justin040304/Stage-TEST-OK/Requirements/TCC1800-UE(A)_poortverschillen.xlsx

 |  |  |  | Specs
 |  |  |  |  |  |  |  |  |  |  |  |  |  |  |  |  |  |  |  |  |  |  | TCC1800-UE |  |  |  |  |  |  |  |  |  |  | TCC1800-UEA
 |  | connector A |  | TCC1800-UE |  |  |  |  |  |  |  | TCC1800-UEA |  |  |  |  |  |  |  |  | connector C |  | Digital inputs |  |  |  |  |  |  |  |  | Digital outputs |  | digital inputs |  |  |  |  |  |  |  |  | Digital outputs
 | pinnummer | TCC1800-UE | TCC1800-UEA | input range | ADC | resolution |  |  |  |  |  | input range | ADC | resolution |  |  |  |  |  | pinnummer | TCC1800-UE | TCC1800-UEA | Schmitt trigger: Low-to-High |  | Schmitt trigger: High-to-LOW |  | extra functionalies |  | max input freq | resolution |  | max out current | extra: connected to | Schmitt trigger: Low-to-High | Schmitt trigger: High-to-LOW | max input voltage | extra functionalies |  | max input freq | resolution |  |  | max out current | extra: connected to
 | 1 | ANA_IN_1 | Analog Input 1 | 0 V ...24 V | 12 bit | 5,9 mV |  |  |  |  |  | 0...60 V | 24 bit | 1 mV | Group 1: 7 single, 3 differential |  |  |  |  | 1 | GND | GND
 | 2 | GND | Analog Input group 1 GND |  |  |  |  |  |  |  |  |  |  |  |  |  |  |  |  | 2 | DIG_IN_1 / DIG_OUT_6.1 | Digital Input 1 / Digital Output 6.1 | 1,5 V |  | 0,75 V |  | 32 bit pulse counter | frequency counter | 3 MHz |  |  | sink: 100mA, peak: 250 mA | power shift register | 16,8V/8,4V/3,5V/1,5V/1,8V | 7V/3,5V/1,45V/0,63V/0,75V | 24 V | 32 bit pulse counter | frequency counter | 3 MHz |  |  |  | sink: 250mA, peak: 1 A | power shift register
 | 3 | ANA_IN_2 | Analog Input 2 + | 0-24 V | 12 bit | 5,9 mV |  |  |  |  |  | 0...60 V | 24 bit | 1 mV |  |  |  |  |  | 3 | DIG_IN_2 / DIG_OUT_6.2 | Digital Input 2 / Digital Output 6.2 | 1,5 V |  | 0,75 V |  | 32 bit pulse counter | pulse width | 200 kHz | 1 us |  | sink: 100mA, peak: 250 mA | power shift register | 16,8V/8,4V/3,5V/1,5V/1,8V | 7V/3,5V/1,45V/0,63V/0,75V | 24 V | 32 bit pulse counter | pulse width | 200 kHz | 1 us |  |  | sink: 250mA, peak: 1 A | power shift register
 | 4 | GND | Analog Input 2 - |  |  |  |  |  |  |  |  | 0…-60 V | 24 bit | 1 mV |  |  |  |  |  | 4 | DIG_IN_3 / DIG_OUT_6.3 | Digital Input 3 / Digital Output 6.3 | 1,5 V |  | 0,75 V |  | 32 bit pulse counter | pulse width | 200 kHz | 1 us |  | sink: 100mA, peak: 250 mA | power shift register | 16,8V/8,4V/3,5V/1,5V/1,8V | 7V/3,5V/1,45V/0,63V/0,75V | 24 V | 32 bit pulse counter | pulse width | 200 kHz | 1 us |  |  | sink: 250mA, peak: 1 A | power shift register
 | 5 | ANA_IN_3 | Analog Input 3 + | 0-24 V | 12 bit | 5,9 mV |  |  |  |  |  | 0...60 V | 24 bit | 1 mV |  |  |  |  |  | 5 | DIG_IN_4 / DIG_OUT_6.4 | Digital Input 4 / Digital Output 6.4 | 1,5 V |  | 0,75 V |  | 32 bit pulse counter | pulse width | 200 kHz | 1 us |  | sink: 100mA, peak: 250 mA | power shift register | 16,8V/8,4V/3,5V/1,5V/1,8V | 7V/3,5V/1,45V/0,63V/0,75V | 24 V | 32 bit pulse counter | pulse width | 200 kHz | 1 us |  |  | sink: 250mA, peak: 1 A | power shift register
 | 6 | GND | Analog Input 3 - |  |  |  |  |  |  |  |  | 0…-60 V | 24 bit | 1 mV |  |  |  |  |  | 6 | DIG_IN_5 / DIG_OUT_6.5 | Digital Input 5 / Digital Output 6.5 | 1,5 V |  | 0,75 V |  | 32 bit pulse counter | pulse width | 200 kHz | 1 us |  | sink: 100mA, peak: 250 mA | power shift register | 16,8V/8,4V/3,5V/1,5V/1,8V | 7V/3,5V/1,45V/0,63V/0,75V | 24 V | 32 bit pulse counter | pulse width | 200 kHz | 1 us |  |  | sink: 250mA, peak: 1 A | power shift register
 | 7 | ANA_IN_4 | Analog Input 4 + | 0-24 V | 12 bit | 5,9 mV |  |  |  |  |  | 0...60 V | 24 bit | 1 mV |  |  |  |  |  | 7 | DIG_IN_6 / DIG_OUT_6.6 | Digital Input 6 / Digital Output 6.6 | 1,5 V |  | 0,75 V |  |  |  |  |  |  | sink: 100mA, peak: 250 mA | power shift register | 16,8V/8,4V/3,5V/1,5V/1,8V | 7V/3,5V/1,45V/0,63V/0,75V | 24 V |  |  |  |  |  |  | sink: 250mA, peak: 1 A | power shift register
 | 8 | GND | Analog Input 4 - |  |  |  |  |  |  |  |  | 0…-60 V | 24 bit | 1 mV |  |  |  |  |  | 8 | DIG_IN_7 / DIG_OUT_6.7 | Digital Input 7 / Digital Output 6.7 | 1,5 V |  | 0,75 V |  |  |  |  |  |  | sink: 100mA, peak: 250 mA | power shift register | 16,8V/8,4V/3,5V/1,5V/1,8V | 7V/3,5V/1,45V/0,63V/0,75V | 24 V |  |  |  |  |  |  | sink: 250mA, peak: 1 A | power shift register
 | 9 | ANA_IN_5 | Analog Input 5 | 0-24 V | 12 bit | 5,9 mV |  |  |  |  |  | 0...60 V | 24 bit | 1 mV | Group 2: 7 single, 3 differential |  |  |  |  | 9 | DIG_IN_8 / DIG_OUT_6.8 | Digital Input 8 / Digital Output 6.8 | 1,5 V |  | 0,75 V |  |  |  |  |  |  | sink: 100mA, peak: 250 mA | power shift register | 16,8V/8,4V/3,5V/1,5V/1,8V | 7V/3,5V/1,45V/0,63V/0,75V | 24 V |  |  |  |  |  |  | sink: 250mA, peak: 1 A | power shift register
 | 10 | GND | Analog Input group 2 GND |  |  |  |  |  |  |  |  |  |  |  |  |  |  |  |  | 10 | GND | GND
 | 11 | ANA_IN_6 | Analog Input 6 + | 0-24 V | 12 bit | 5,9 mV |  |  |  |  |  | 0...60 V | 24 bit | 1 mV |  |  |  |  |  | 11 | DIG_IN_9 / SPI_DI | Digital Input 9 / SPI_DI | 1,5 V |  | 0,75 V |  |  |  |  |  |  |  |  | 16,8V/8,4V/3,5V/1,5V/1,8V | 7V/3,5V/1,45V/0,63V/0,75V | 24 V
 | 12 | GND | Analog Input 6 - |  |  |  |  |  |  |  |  | 0…-60 V | 24 bit | 1 mV |  |  |  |  |  | 12 | DIG_IN_10 | Digital Input 10 | 1,5 V |  | 0,75 V |  |  |  |  |  |  |  |  | 16,8V/8,4V/3,5V/1,5V/1,8V | 7V/3,5V/1,45V/0,63V/0,75V | 24 V
 | 13 | ANA_IN_7 | Analog Input 7 + | 0-24 V | 12 bit | 5,9 mV |  |  |  |  |  | 0...60 V | 24 bit | 1 mV |  |  |  |  |  | 13 | DIG_IN_11 | Digital Input 11 | 1,5 V |  | 0,75 V |  |  |  |  |  |  |  |  | 16,8V/8,4V/3,5V/1,5V/1,8V | 7V/3,5V/1,45V/0,63V/0,75V | 24 V
 | 14 | GND | Analog Input 7 - |  |  |  |  |  |  |  |  | 0…-60 V | 24 bit | 1 mV |  |  |  |  |  | 14 | DIG_IN_12 | Digital Input 12 | 1,5 V |  | 0,75 V |  |  |  |  |  |  |  |  | 16,8V/8,4V/3,5V/1,5V/1,8V | 7V/3,5V/1,45V/0,63V/0,75V | 24 V
 | 15 | ANA_IN_8 | Analog Input 8 + | 0-24 V | 12 bit | 5,9 mV |  |  |  |  |  | 0...60 V | 24 bit | 1 mV |  |  |  |  |  | 15 | DIG_IN_13 | Digital Input 13 | 1,5 V |  | 0,75 V |  |  |  |  |  |  |  |  | 16,8V/8,4V/3,5V/1,5V/1,8V | 7V/3,5V/1,45V/0,63V/0,75V | 24 V
 | 16 | GND | Analog Input 8 - |  |  |  |  |  |  |  |  | 0…-60 V | 24 bit | 1 mV |  |  |  |  |  | 16 | DIG_IN_14 | Digital Input 14 | 1,5 V |  | 0,75 V |  |  |  |  |  |  |  |  | 16,8V/8,4V/3,5V/1,5V/1,8V | 7V/3,5V/1,45V/0,63V/0,75V | 24 V
 | 17 | ANA_IN_9 | Analog Input 9 | 0-24 V | 12 bit | 5,9 mV |  |  |  |  |  | 0...60 V | 24 bit | 1 mV | Group 3: 7 single, 3 differential |  |  |  |  | 17 | DIG_IN_15 | Digital Input 15 | 1,5 V |  | 0,75 V |  |  |  |  |  |  |  |  | 16,8V/8,4V/3,5V/1,5V/1,8V | 7V/3,5V/1,45V/0,63V/0,75V | 24 V
 | 18 | GND | Analog Input group 3 GND |  |  |  |  |  |  |  |  |  |  | 1 mV |  |  |  |  |  | 18 | DIG_IN_16 | Digital Input 16 | 1,5 V |  | 0,75 V |  |  |  |  |  |  |  |  | 16,8V/8,4V/3,5V/1,5V/1,8V | 7V/3,5V/1,45V/0,63V/0,75V | 24 V
 | 19 | ANA_IN_10 | Analog Input 10 + | 0-24 V | 12 bit | 5,9 mV |  |  |  |  |  | 0...60 V | 24 bit | 1 mV |  |  |  |  |  | 19 | GND | GND
 | 20 | GND | Analog Input 10 - |  |  |  |  |  |  |  |  | 0…-60 V | 24 bit | 1 mV |  |  |  |  |  | 20 | DIG_IN_17 | Digital Input 17 / ETHERNET P4- | 1,5 V |  | 0,75 V |  |  |  |  |  |  |  |  | 16,8V/8,4V/3,5V/1,5V/1,8V | 7V/3,5V/1,45V/0,63V/0,75V | 24 V
 | 21 | ANA_IN_11 | Analog Input 11 + | 0-24 V | 12 bit | 5,9 mV |  |  |  |  |  | 0...60 V | 24 bit | 1 mV |  |  |  |  |  | 21 | DIG_IN_18 | Digital Input 18 / ETHERNET P4+ | 1,5 V |  | 0,75 V |  |  |  |  |  |  |  |  | 16,8V/8,4V/3,5V/1,5V/1,8V | 7V/3,5V/1,45V/0,63V/0,75V | 24 V
 | 22 | GND | Analog Input 11 - |  |  |  |  |  |  |  |  | 0…-60 V | 24 bit | 1 mV |  |  |  |  |  | 22 | DIG_IN_19 | Digital Input 19 / ETHERNET P3- | 1,5 V |  | 0,75 V |  |  |  |  |  |  |  |  | 16,8V/8,4V/3,5V/1,5V/1,8V | 7V/3,5V/1,45V/0,63V/0,75V | 24 V
 | 23 | ANA_IN_12 | Analog Input 12 + | 0-24 V | 12 bit | 5,9 mV |  |  |  |  |  | 0...60 V | 24 bit | 1 mV |  |  |  |  |  | 23 | DIG_IN_20 | Digital Input 20 / ETHERNET P3+ | 1,5 V |  | 0,75 V |  |  |  |  |  |  |  |  | 16,8V/8,4V/3,5V/1,5V/1,8V | 7V/3,5V/1,45V/0,63V/0,75V | 24 V
 | 24 | GND | Analog Input 12 - |  |  |  |  |  |  |  |  | 0…-60 V | 24 bit | 1 mV |  |  |  |  |  | 24 | ETHERNET_RX+ | Digital Input 21 / ETHERNET P2- |  |  |  |  |  |  |  |  |  |  |  | 16,8V/8,4V/3,5V/1,5V/1,8V | 7V/3,5V/1,45V/0,63V/0,75V | 24 V
 | 25 | ANA_IN_13 | Analog Input 13 | 0-24 V | 12 bit | 5,9 mV |  |  |  |  |  | 0...60 V | 24 bit | 1 mV | Group 4: 7 single, 3 differential |  |  |  |  | 25 | ETHERNET_RX- | Digital Input 22 / ETHERNET P2+ |  |  |  |  |  |  |  |  |  |  |  | 16,8V/8,4V/3,5V/1,5V/1,8V | 7V/3,5V/1,45V/0,63V/0,75V | 24 V
 | 26 | GND | Analog Input group 4 GND |  |  |  |  |  |  |  |  |  |  |  |  |  |  |  |  | 26 | ETHERNET_TX+ | Digital Input 23 / ETHERNET P1- |  |  |  |  |  |  |  |  |  |  |  | 16,8V/8,4V/3,5V/1,5V/1,8V | 7V/3,5V/1,45V/0,63V/0,75V | 24 V
 | 27 | ANA_IN_14 | Analog Input 14 + | 0-24 V | 12 bit | 5,9 mV |  |  |  |  |  | 0...60 V | 24 bit | 1 mV |  |  |  |  |  | 27 | ETHERNET_TX- | Digital Input 24 / ETHERNET P1+ |  |  |  |  |  |  |  |  |  |  |  | 16,8V/8,4V/3,5V/1,5V/1,8V | 7V/3,5V/1,45V/0,63V/0,75V | 24 V
 | 28 | GND | Analog Input 14 - |  |  |  |  |  |  |  |  | 0…-60 V | 24 bit | 1 mV |  |  |  |  |  | 28 | GND | GND
 | 29 | ANA_IN_15 | Analog Input 15 + | 0-24 V | 12 bit | 5,9 mV |  |  |  |  |  | 0...60 V | 24 bit | 1 mV |  |  |  |  |  | 29 | EXT_CLK | EXT_CLK
 | 30 | GND | Analog Input 15 - |  |  |  |  |  |  |  |  | 0…-60 V | 24 bit | 1 mV |  |  |  |  |  | 30 | EXT_IN | EXT_IN
 | 31 | ANA_IN_16 | Analog Input 16 + | 0-24 V | 12 bit | 5,9 mV |  |  |  |  |  | 0...60 V | 24 bit | 1 mV |  |  |  |  |  | 31 | EXT_LOAD | EXT_LOAD
 | 32 | GND | Analog Input 16 - |  |  |  |  |  |  |  |  | 0…-60 V | 24 bit | 1 mV
 |  |  |  | input range | ADC | resolution | max out current |  |  |  |  | input range | ADC | resolution | max out current |  |  |  |  | 32 | EXT_OUT | EXT_OUT
 | 33 | ANA_OUT_1 | Analog Output 1 | 0-24 V | 12 bit | 5,9 mV | Source: 40 mA, sink: 20 mA |  |  |  |  | 0-24 V | 12 bit | 5,9 mV | Source: 40 mA, sink: 20 mA |  |  |  |  | 33 | EXT_STROBE | EXT_STROBE
 | 34 | ANA_OUT_2 | Analog Output 2 | 0-24 V | 12 bit | 5,9 mV | Source: 40 mA, sink: 20 mA |  |  |  |  | 0-24 V | 12 bit | 5,9 mV | Source: 40 mA, sink: 20 mA |  |  |  |  | 34 | GND | GND
 |  |  |  |  |  |  |  |  |  |  |  |  |  |  |  |  |  |  |  |  |  |  | Serial channel |  |  |  |  |  |  |  |  |  |  | UART & RS485 |  |  |  | Serial channel
 |  |  |  |  |  |  |  |  |  |  |  |  |  |  |  |  |  |  |  |  |  |  | uitgangsspanning | uitgangsweerstand | baudrate | databits | parity | stop bits |  |  |  |  |  | uitgangsspanning | uitgangsweerstand | resolutie | max out current |  |  | baudrate | databits | parity | stop bits
 | 35 | GND | GND |  |  |  |  |  |  |  |  |  |  |  |  |  |  |  |  | 35 | SERIAL_RX | SERIAL TX / RS485 A | 5V | 330 Ω | 300 .. 115200 | 8 | none | 1 or 2 |  |  |  |  |  | 1,8V-5V | 100 Ω | 1.3 mV | 12mA |  |  | 300-115200 | 7 or 8 | none | 1 or 2
 | 36 | ANA_OUT_3 | Analog Output 3 | 0-24 V | 12 bit | 5,9 mV | Source: 40 mA, sink: 20 mA |  |  |  |  | 0-24 V | 12 bit | 5,9 mV | Source: 40 mA, sink: 20 mA |  |  |  |  | 36 | SERIAL_TX | SERIAL RX / RS485 B | 5V | 331 Ω | 300 .. 115200 | 9 | none | 2 or 2 |  |  |  |  |  |  | 100 Ω
 |  |  |  |  |  |  |  |  |  |  |  |  |  |  |  |  |  |  |  |  |  |  | uitgangsspanning | uitgangsstroom | uitgangsweerstand | output frequency | duty cycle |  |  |  |  |  |  | uitgangsspanning | uitgangsstroom | uitgangsweerstand | output frequency | duty cycle
 | 37 | ANA_OUT_4 | Analog Output 4 | 0-24 V | 12 bit | 5,9 mV | Source: 40 mA, sink: 20 mA |  |  |  |  | 0-24 V | 12 bit | 5,9 mV | Source: 40 mA, sink: 20 mA |  |  |  |  | 37 | PWM_1 | PWM 1 | 5V | 40mA | 100 Ω / 100mW | 2.38 Hz .. 40 MHz | 0 .. 100 % |  |  |  |  |  |  | 1,8V-5V | 12mA | 100 Ω | 2.38 Hz .. 40 MHz | 0 .. 100 %
 | 38 | GND | GND |  |  |  |  |  |  |  |  |  |  |  |  |  |  |  |  | 38 | PWM_2 | PWM 2 | 5V | 40mA | 100 Ω / 100mW | 2.38 Hz .. 40 MHz | 0 .. 100 % |  |  |  |  |  |  | 1,8V-5V | 12mA | 100 Ω | 2.38 Hz .. 40 MHz | 0 .. 100 %
 |  |  |  |  |  |  |  |  |  |  |  |  |  |  |  |  |  |  |  |  |  |  | uitgangsspanning | frequency | uitgangsweerstand | pullup resistor |  |  |  |  |  |  |  | uitgangsspanning | frequency | uitgangsweerstand | pullup resistor
 | 39 | ANA_OUT_5 | Analog Output 5 | 0-24 V | 12 bit | 5,9 mV | Source: 40 mA, sink: 20 mA |  |  |  |  | 0-24 V | 12 bit | 5,9 mV | Source: 40 mA, sink: 20 mA |  |  |  |  | 39 | I2C_SDA | I2C SDA | 5V | 100kHz or 400 kHz | 330 Ω | 100kHz: 4K7, 400kHz: 2K |  |  |  |  |  |  |  | 1,8V-5V | 100kHz or 400 kHz | 100 Ω | optional: 4K7
 | 40 | ANA_OUT_6 | Analog Output 6 | 0-24 V | 12 bit | 5,9 mV | Source: 40 mA, sink: 20 mA |  |  |  |  | 0-24 V | 12 bit | 5,9 mV | Source: 40 mA, sink: 20 mA |  |  |  |  | 40 | I2C_SCL | I2C SCL |  | 100kHz or 400 kHz | 330 Ω |  |  |  |  |  |  |  |  | 1,8V-5V | 100kHz or 400 kHz | 100 Ω
 | 41 | GND | GND |  |  |  |  |  |  |  |  |  |  |  |  |  |  |  |  | 41 | GND | GND
 | 42 | ANA_OUT_7 | Analog Output 7 | 0-24 V | 12 bit | 5,9 mV | Source: 40 mA, sink: 20 mA |  |  |  |  | 0-24 V | 12 bit | 5,9 mV | Source: 40 mA, sink: 20 mA |  |  |  |  | 42 | GND | GND
 |  |  |  |  |  |  |  |  |  |  |  |  |  |  |  |  |  |  |  |  |  |  | output voltage | max current |  |  |  |  |  |  |  |  |  | output voltage | max current
 | 43 | ANA_OUT_8 | Analog Output 8 | 0-24 V | 12 bit | 5,9 mV | Source: 40 mA, sink: 20 mA |  |  |  |  | 0-24 V | 12 bit | 5,9 mV | Source: 40 mA, sink: 20 mA |  |  |  |  | 43 | +26V | +27V / 1A | 27V…30V | 0,75A |  |  |  |  |  |  |  |  |  | 27V | 1A
 | 44 | GND | GND |  |  |  |  |  |  |  |  |  |  |  |  |  |  |  |  | 44 | +26V | +27V / 1A
 |  |  |  |  |  |  |  |  |  |  |  |  |  |  |  |  |  |  |  |  |  |  |  |  |  |  |  |  |  | current measurement
 |  |  |  |  |  |  |  |  |  |  |  |  |  |  |  |  |  |  |  |  |  |  | output voltage | resolution | bit | accuracy max | max power | max current |  | resolution | full range non-lin | stable current | power supply off | output voltage | resolution | bit | accuracy max | max power | max current |  | resolution | full range non-lin | stable current | power supply off
 | 45 | ANA_OUT_9 | Analog Output 9 | 0-24 V | 12 bit | 5,9 mV | Source: 40 mA, sink: 20 mA |  |  |  |  | 0-24 V | 12 bit | 5,9 mV | Source: 40 mA, sink: 20 mA |  |  |  |  | 45 | V_SUPPLY_1 | Supply 1 | 1,24V…24V | 6mV | 12 | 4% | 45W | 3A |  | 0,375 mA | 0,9 % typ | na 480ms | no communication PC | 1,24V…24V | 6mV | 12 | 4% | 45W | 3A |  | 0,375 mA | 0,9 % typ | na 480ms | no communication PC
 | 46 | ANA_OUT_10 | Analog Output 10 | 0-24 V | 12 bit | 5,9 mV | Source: 40 mA, sink: 20 mA |  |  |  |  | 0-24 V | 12 bit | 5,9 mV | Source: 40 mA, sink: 20 mA |  |  |  |  | 46 | GND | GND
 | 47 | GND | GND |  |  |  |  |  |  |  |  |  |  |  |  |  |  |  |  | 47 | V_SUPPLY_1 | Supply 1 | 1,24V…24V | 6mV | 12 | 4% | 45W | 3A |  | 0,375 mA | 0,9 % typ | na 480ms | no communication PC | 1,24V…24V | 6mV | 12 | 4% | 45W | 3A |  | 0,375 mA | 0,9 % typ | na 480ms | no communication PC
 | 48 | ANA_OUT_11 | Analog Output 11 | 0-24 V | 12 bit | 5,9 mV | Source: 40 mA, sink: 20 mA |  |  |  |  | 0-24 V | 12 bit | 5,9 mV | Source: 40 mA, sink: 20 mA |  |  |  |  | 48 | GND | GND
 | 49 | ANA_OUT_12 | Analog Output 12 | 0-24 V | 12 bit | 5,9 mV | Source: 40 mA, sink: 20 mA |  |  |  |  | 0-24 V | 12 bit | 5,9 mV | Source: 40 mA, sink: 20 mA |  |  |  |  | 49 | V_SUPPLY_1 | Supply 1 | 1,24V…24V | 6mV | 12 | 4% | 45W | 3A |  | 0,375 mA | 0,9 % typ | na 480ms | no communication PC | 1,24V…24V | 6mV | 12 | 4% | 45W | 3A |  | 0,375 mA | 0,9 % typ | na 480ms | no communication PC
 | 50 | GND | GND |  |  |  |  |  |  |  |  |  |  |  |  |  |  |  |  | 50 | GND | GND
 | 51 | ANA_OUT_13 | Analog Output 13 | 0-24 V | 12 bit | 5,9 mV | Source: 40 mA, sink: 20 mA |  |  |  |  | 0-24 V | 12 bit | 5,9 mV | Source: 40 mA, sink: 20 mA |  |  |  |  | 51 | V_SUPPLY_1 | Supply 1 | 1,24V…24V | 6mV | 12 | 4% | 45W | 3A |  | 0,375 mA | 0,9 % typ | na 480ms | no communication PC | 1,24V…24V | 6mV | 12 | 4% | 45W | 3A |  | 0,375 mA | 0,9 % typ | na 480ms | no communication PC
 | 52 | ANA_OUT_14 | Analog Output 14 | 0-24 V | 12 bit | 5,9 mV | Source: 40 mA, sink: 20 mA |  |  |  |  | 0-24 V | 12 bit | 5,9 mV | Source: 40 mA, sink: 20 mA |  |  |  |  | 52 | GND | GND
 | 53 | GND | GND |  |  |  |  |  |  |  |  |  |  |  |  |  |  |  |  | 53 | V_SUPPLY_1 | Supply 1 | 1,24V…24V | 6mV | 12 | 4% | 45W | 3A |  | 0,375 mA | 0,9 % typ | na 480ms | no communication PC | 1,24V…24V | 6mV | 12 | 4% | 45W | 3A |  | 0,375 mA | 0,9 % typ | na 480ms | no communication PC
 | 54 | ANA_OUT_15 | Analog Output 15 | 0-24 V | 12 bit | 5,9 mV | Source: 40 mA, sink: 20 mA |  |  |  |  | 0-24 V | 12 bit | 5,9 mV | Source: 40 mA, sink: 20 mA |  |  |  |  | 54 | GND | GND
 | 55 | ANA_OUT_16 | Analog Output 16 | 0-24 V | 12 bit | 5,9 mV | Source: 40 mA, sink: 20 mA |  |  |  |  | 0-24 V | 12 bit | 5,9 mV | Source: 40 mA, sink: 20 mA |  |  |  |  | 55 | V_SUPPLY_2 | Supply 2 | 1,24V…24V | 6mV | 12 | 4% | 45W | 3A |  | 0,375 mA | 0,9 % typ | na 480ms | no communication PC | 1,24V…24V | 6mV | 12 | 4% | 45W | 3A |  | 0,375 mA | 0,9 % typ | na 480ms | no communication PC
 | 56 | GND | GND |  |  |  |  |  |  |  |  |  |  |  |  |  |  |  |  | 56 | GND | GND
 | 57 | BOARD_DETECT | BOARD DETECT |  |  |  |  |  |  |  |  |  |  |  |  |  |  |  |  | 57 | V_SUPPLY_2 | Supply 2 | 1,24V…24V | 6mV | 12 | 4% | 45W | 3A |  | 0,375 mA | 0,9 % typ | na 480ms | no communication PC | 1,24V…24V | 6mV | 12 | 4% | 45W | 3A |  | 0,375 mA | 0,9 % typ | na 480ms | no communication PC
 | 58 | Reserved | Reserved |  |  |  |  |  |  |  |  |  |  |  |  |  |  |  |  | 58 | GND | GND
 | 59 | Reserved | Reserved |  |  |  |  |  |  |  |  |  |  |  |  |  |  |  |  | 59 | V_SUPPLY_2 | Supply 2 | 1,24V…24V | 6mV | 12 | 4% | 45W | 3A |  | 0,375 mA | 0,9 % typ | na 480ms | no communication PC | 1,24V…24V | 6mV | 12 | 4% | 45W | 3A |  | 0,375 mA | 0,9 % typ | na 480ms | no communication PC
 | 60 | GND | GND |  |  |  |  |  |  |  |  |  |  |  |  |  |  |  |  | 60 | GND | GND
 |  |  |  | Speed |  | USB hub connection | max out |  |  |  |  | Speed |  | USB hub connection | max out
 | 61 | USB_VBUS | USB VBUS2 | High speed USB 2.0 |  | ethernet | 5 V |  |  |  |  | High speed USB 2.0 |  | ethernet | 5 V |  |  |  |  | 61 | V_SUPPLY_2 | Supply 2 | 1,24V…24V | 6mV | 12 | 4% | 45W | 3A |  | 0,375 mA | 0,9 % typ | na 480ms | no communication PC | 1,24V…24V | 6mV | 12 | 4% | 45W | 3A |  | 0,375 mA | 0,9 % typ | na 480ms | no communication PC
 | 62 | USB_D+ | USB D+ |  |  |  | 500 mA |  |  |  |  |  |  |  | 500 mA |  |  |  |  | 62 | GND | GND
 | 63 | USB_D- | USB D- |  |  |  | 500 mA |  |  |  |  |  |  |  | 500 mA |  |  |  |  | 63 | V_SUPPLY_2 | Supply 2 | 1,24V…24V | 6mV | 12 | 4% | 45W | 3A |  | 0,375 mA | 0,9 % typ | na 480ms | no communication PC | 1,24V…24V | 6mV | 12 | 4% | 45W | 3A |  | 0,375 mA | 0,9 % typ | na 480ms | no communication PC
 | 64 | USB_GND | USB GND |  |  |  |  |  |  |  |  |  |  |  |  |  |  |  |  | 64 | GND | GND
 |  |  |  |  |  |  |  |  |  |  |  |  |  |  |  |  |  |  |  |  | connector P
 |  |  |  |  |  |  |  |  |  |  |  |  |  |  |  |  |  |  |  | pinnummer | TCC1800-UE | TCC1800-UEA
 | goed |  |  | Specs |  |  |  |  |  |  |  |  |  |  |  |  |  |  |  | 1 | PANEL_CLK | PANEL_CLK
 |  | connector B |  | TCC1800-UE |  |  |  |  |  |  |  | TCC1800-UEA |  |  |  |  |  |  |  | 2 | PANEL +5V | PANEL +5V
 |  |  |  |  |  |  |  |  | SPI |  |  |  |  |  |  |  | SPI |  |  | 3 | PANEL_SDI | PANEL_SDI
 | pinnummer | TCC1800-UE | TCC1800-UEA | output high | output low | output resistor | max out current | max out power | kloksnelheid |  |  | output high | output low | output resistor | max out current | max out power | kloksnelheid |  |  | 4 | PANEL_LOAD | PANEL_LOAD
 | 1 | GND | GND |  |  |  |  |  |  |  |  |  |  |  |  |  |  |  |  | 5 | PANEL_STROBE | PANEL_STROBE
 | 2 | DIG_OUT_1.1 / SPI_CLK | Digital Output 1.1 / SPI_CLK | 2,5V… 24V | 0V | 100 Ω / 100mW | Source: 30 mA, sink: 30 mA | 500mW | 78 kHz, 156.25 kHz , 312.50 kHz |  |  | 2,5V… 24V | 0,125V | 100 Ω / 100mW | Source: 30 mA, sink: 30 mA |  | 78 kHz, 156.25 kHz , 312.50 kHz |  |  | 6 | PANEL_SDO | PANEL_SDO
 | 3 | DIG_OUT_1.2 / SPI_DO | Digital Output 1.2 / SPI_DO | 2,5V… 24V | 0V | 100 Ω / 100mW | Source: 30 mA, sink: 30 mA | 500mW |  |  |  | 2,5V… 24V | 0,125V | 100 Ω / 100mW | Source: 30 mA, sink: 30 mA | 500mW |  |  |  | 7 | +DC IN | +DC IN
 | 4 | DIG_OUT_1.3 | Digital Output 1.3 | 2,5V… 24V | 0V | 100 Ω / 100mW | Source: 30 mA, sink: 30 mA | 500mW |  |  |  | 2,5V… 24V | 0,125V | 100 Ω / 100mW | Source: 30 mA, sink: 30 mA | 500mW |  |  |  | 8 | GND | GND
 | 5 | DIG_OUT_1.4 | Digital Output 1.4 | 2,5V… 24V | 0V | 100 Ω / 100mW | Source: 30 mA, sink: 30 mA | 500mW |  |  |  | 2,5V… 24V | 0,125V | 100 Ω / 100mW | Source: 30 mA, sink: 30 mA | 500mW |  |  |  | 9 | +DC IN | +DC IN
 | 6 | DIG_OUT_1.5 | Digital Output 1.5 | 2,5V… 24V | 0V | 100 Ω / 100mW | Source: 30 mA, sink: 30 mA | 500mW |  |  |  | 2,5V… 24V | 0,125V | 100 Ω / 100mW | Source: 30 mA, sink: 30 mA | 500mW |  |  |  | 10 | GND | GND
 | 7 | DIG_OUT_1.6 | Digital Output 1.6 | 2,5V… 24V | 0V | 100 Ω / 100mW | Source: 30 mA, sink: 30 mA | 500mW |  |  |  | 2,5V… 24V | 0,125V | 100 Ω / 100mW | Source: 30 mA, sink: 30 mA | 500mW |  |  |  | 11 | +DC IN | +DC IN
 | 8 | DIG_OUT_1.7 | Digital Output 1.7 | 2,5V… 24V | 0V | 100 Ω / 100mW | Source: 30 mA, sink: 30 mA | 500mW |  |  |  | 2,5V… 24V | 0,125V | 100 Ω / 100mW | Source: 30 mA, sink: 30 mA | 500mW |  |  |  | 12 | GND | GND
 | 9 | DIG_OUT_1.8 | Digital Output 1.8 | 2,5V… 24V | 0V | 100 Ω / 100mW | Source: 30 mA, sink: 30 mA | 500mW |  |  |  | 2,5V… 24V | 0,125V | 100 Ω / 100mW | Source: 30 mA, sink: 30 mA | 500mW |  |  |  | 13 | +DC IN | +DC IN
 | 10 | GND | GND |  |  |  |  |  |  |  |  |  |  |  |  | 500mW |  |  |  | 14 | GND | GND
 | 11 | DIG_OUT_2.1 | Digital Output 2.1 | 2,5V… 24V | 0V | 100 Ω / 100mW | Source: 40 mA, sink: 20 mA | 500mW |  |  |  | 2,5V… 24V | 0V | 100 Ω / 100mW | Source: 40 mA, sink: 20 mA |  |  |  |  | 15 | +DC IN | +DC IN
 | 12 | DIG_OUT_2.2 | Digital Output 2.2 | 2,5V… 24V | 0V | 100 Ω / 100mW | Source: 40 mA, sink: 20 mA | 500mW |  |  |  | 2,5V… 24V | 0V | 100 Ω / 100mW | Source: 40 mA, sink: 20 mA | 500mW |  |  |  | 16 | GND | GND
 | 13 | DIG_OUT_2.3 | Digital Output 2.3 | 2,5V… 24V | 0V | 100 Ω / 100mW | Source: 40 mA, sink: 20 mA | 500mW |  |  |  | 2,5V… 24V | 0V | 100 Ω / 100mW | Source: 40 mA, sink: 20 mA | 500mW |  |  |  | 17 | ETH1 TX- | ETH1 TX-
 | 14 | DIG_OUT_2.4 | Digital Output 2.4 | 2,5V… 24V | 0V | 100 Ω / 100mW | Source: 40 mA, sink: 20 mA | 500mW |  |  |  | 2,5V… 24V | 0V | 100 Ω / 100mW | Source: 40 mA, sink: 20 mA | 500mW |  |  |  | 18 | ETH1 RX- | ETH1 RX-
 | 15 | DIG_OUT_2.5 | Digital Output 2.5 | 2,5V… 24V | 0V | 100 Ω / 100mW | Source: 40 mA, sink: 20 mA | 500mW |  |  |  | 2,5V… 24V | 0V | 100 Ω / 100mW | Source: 40 mA, sink: 20 mA | 500mW |  |  |  | 19 | ETH1 TX+ | ETH1 TX+
 | 16 | DIG_OUT_2.6 | Digital Output 2.6 | 2,5V… 24V | 0V | 100 Ω / 100mW | Source: 40 mA, sink: 20 mA | 500mW |  |  |  | 2,5V… 24V | 0V | 100 Ω / 100mW | Source: 40 mA, sink: 20 mA | 500mW |  |  |  | 20 | ETH1 RX+ | ETH1 RX+
 | 17 | DIG_OUT_2.7 | Digital Output 2.7 | 2,5V… 24V | 0V | 100 Ω / 100mW | Source: 40 mA, sink: 20 mA | 500mW |  |  |  | 2,5V… 24V | 0V | 100 Ω / 100mW | Source: 40 mA, sink: 20 mA | 500mW |  |  |  | 21 | ETH2 TX- | ETH2 TX-
 | 18 | DIG_OUT_2.8 | Digital Output 2.8 | 2,5V… 24V | 0V | 100 Ω / 100mW | Source: 40 mA, sink: 20 mA | 500mW |  |  |  | 2,5V… 24V | 0V | 100 Ω / 100mW | Source: 40 mA, sink: 20 mA | 500mW |  |  |  | 22 | ETH2 RX- | ETH2 RX-
 | 19 | GND | GND |  |  |  |  |  |  |  |  |  |  |  |  | 500mW |  |  |  | 23 | ETH2 TX+ | ETH2 TX+
 | 20 | DIG_OUT_3.1 | Digital Output 3.1 | 2,5V… 24V | 0V | 100 Ω / 100mW | Source: 40 mA, sink: 20 mA | 500mW |  |  |  | 2,5V… 24V | 0V | 100 Ω / 100mW | Source: 40 mA, sink: 20 mA |  |  |  |  | 24 | ETH2 RX+ | ETH2 RX+
 | 21 | DIG_OUT_3.2 | Digital Output 3.2 | 2,5V… 24V | 0V | 100 Ω / 100mW | Source: 40 mA, sink: 20 mA | 500mW |  |  |  | 2,5V… 24V | 0V | 100 Ω / 100mW | Source: 40 mA, sink: 20 mA | 500mW |  |  |  | 25 | USB D- | USB D-
 | 22 | DIG_OUT_3.3 | Digital Output 3.3 | 2,5V… 24V | 0V | 100 Ω / 100mW | Source: 40 mA, sink: 20 mA | 500mW |  |  |  | 2,5V… 24V | 0V | 100 Ω / 100mW | Source: 40 mA, sink: 20 mA | 500mW |  |  |  | 26 | VBUS | VBUS
 | 23 | DIG_OUT_3.4 | Digital Output 3.4 | 2,5V… 24V | 0V | 100 Ω / 100mW | Source: 40 mA, sink: 20 mA | 500mW |  |  |  | 2,5V… 24V | 0V | 100 Ω / 100mW | Source: 40 mA, sink: 20 mA | 500mW |  |  |  | 27 | USB D+ | USB D+
 | 24 | DIG_OUT_3.5 | Digital Output 3.5 | 2,5V… 24V | 0V | 100 Ω / 100mW | Source: 40 mA, sink: 20 mA | 500mW |  |  |  | 2,5V… 24V | 0V | 100 Ω / 100mW | Source: 40 mA, sink: 20 mA | 500mW |  |  |  | 28 | USB GND | USB GND
 | 25 | DIG_OUT_3.6 | Digital Output 3.6 | 2,5V… 24V | 0V | 100 Ω / 100mW | Source: 40 mA, sink: 20 mA | 500mW |  |  |  | 2,5V… 24V | 0V | 100 Ω / 100mW | Source: 40 mA, sink: 20 mA | 500mW |  |  |  | 29 | !EXP_SELECT1 | !EXP_SELECT1
 | 26 | DIG_OUT_3.7 | Digital Output 3.7 | 2,5V… 24V | 0V | 100 Ω / 100mW | Source: 40 mA, sink: 20 mA | 500mW |  |  |  | 2,5V… 24V | 0V | 100 Ω / 100mW | Source: 40 mA, sink: 20 mA | 500mW |  |  |  | 30 | EXP_RESERVED | EXP_RESERVED
 | 27 | DIG_OUT_3.8 | Digital Output 3.8 | 2,5V… 24V | 0V | 100 Ω / 100mW | Source: 40 mA, sink: 20 mA | 500mW |  |  |  | 2,5V… 24V | 0V | 100 Ω / 100mW | Source: 40 mA, sink: 20 mA | 500mW |  |  |  | 31 | RESERVED_1 | RESERVED_1
 | 28 | GND | GND |  |  |  |  |  |  |  |  |  |  |  |  | 500mW |  |  |  | 32 | RESERVED_2 | RESERVED_2
 | 29 | DIG_OUT_4.1 | Digital Output 4.1 | 5,5V… 24V |  |  | 500 mA |  |  |  |  | 5,5V… 24V |  |  | 500 mA |  |  |  |  | Note: | diff connectors
 | 30 | DIG_OUT_4.2 | Digital Output 4.2 | 5,5V… 24V |  |  | 500 mA |  |  |  |  | 5,5V… 24V |  |  | 500 mA
 | 31 | DIG_OUT_4.3 | Digital Output 4.3 | 5,5V… 24V |  |  | 500 mA |  |  |  |  | 5,5V… 24V |  |  | 500 mA
 | 32 | DIG_OUT_4.4 | Digital Output 4.4 | 5,5V… 24V |  |  | 500 mA |  |  |  |  | 5,5V… 24V |  |  | 500 mA
 | 33 | GND | GND
 |  |  |  |  |  |  | max out current | extra: connected to |  |  |  |  |  |  | max out current | extra: connected to
 | 34 | DIG_OUT_5.1 | Digital Output 5.1 |  |  |  | sink: 100mA, peak: 250 mA | power shift register |  |  |  |  |  |  | sink: 250mA, peak: 1 A | power shift register
 | 35 | DIG_OUT_5.2 | Digital Output 5.2 |  |  |  | sink: 100mA, peak: 250 mA | power shift register |  |  |  |  |  |  | sink: 250mA, peak: 1 A | power shift register
 | 36 | DIG_OUT_5.3 | Digital Output 5.3 |  |  |  | sink: 100mA, peak: 250 mA | power shift register |  |  |  |  |  |  | sink: 250mA, peak: 1 A | power shift register
 | 37 | DIG_OUT_5.4 | Digital Output 5.4 |  |  |  | sink: 100mA, peak: 250 mA | power shift register |  |  |  |  |  |  | sink: 250mA, peak: 1 A | power shift register
 | 38 | DIG_OUT_5.5 | Digital Output 5.5 |  |  |  | sink: 100mA, peak: 250 mA | power shift register |  |  |  |  |  |  | sink: 250mA, peak: 1 A | power shift register
 | 39 | DIG_OUT_5.6 | Digital Output 5.6 |  |  |  | sink: 100mA, peak: 250 mA | power shift register |  |  |  |  |  |  | sink: 250mA, peak: 1 A | power shift register
 | 40 | DIG_OUT_5.7 | Digital Output 5.7 |  |  |  | sink: 100mA, peak: 250 mA | power shift register |  |  |  |  |  |  | sink: 250mA, peak: 1 A | power shift register
 | 41 | DIG_OUT_5.8 | Digital Output 5.8 |  |  |  | sink: 100mA, peak: 250 mA | power shift register |  |  |  |  |  |  | sink: 250mA, peak: 1 A | power shift register
 | 42 | GND | GND
 | 43 | DIG_OUT_5.9 | Digital Output 5.9 |  |  |  | sink: 100mA, peak: 250 mA | power shift register |  |  |  |  |  |  | sink: 250mA, peak: 1 A | power shift register
 | 44 | DIG_OUT_5.10 | Digital Output 5.10 |  |  |  | sink: 100mA, peak: 250 mA | power shift register |  |  |  |  |  |  | sink: 250mA, peak: 1 A | power shift register
 | 45 | DIG_OUT_5.11 | Digital Output 5.11 |  |  |  | sink: 100mA, peak: 250 mA | power shift register |  |  |  |  |  |  | sink: 250mA, peak: 1 A | power shift register
 | 46 | DIG_OUT_5.12 | Digital Output 5.12 |  |  |  | sink: 100mA, peak: 250 mA | power shift register |  |  |  |  |  |  | sink: 250mA, peak: 1 A | power shift register
 | 47 | DIG_OUT_5.13 | Digital Output 5.13 |  |  |  | sink: 100mA, peak: 250 mA | power shift register |  |  |  |  |  |  | sink: 250mA, peak: 1 A | power shift register
 | 48 | DIG_OUT_5.14 | Digital Output 5.14 |  |  |  | sink: 100mA, peak: 250 mA | power shift register |  |  |  |  |  |  | sink: 250mA, peak: 1 A | power shift register
 | 49 | DIG_OUT_5.15 | Digital Output 5.15 |  |  |  | sink: 100mA, peak: 250 mA | power shift register |  |  |  |  |  |  | sink: 250mA, peak: 1 A | power shift register
 | 50 | DIG_OUT_5.16 | Digital Output 5.16 |  |  |  | sink: 100mA, peak: 250 mA | power shift register |  |  |  |  |  |  | sink: 250mA, peak: 1 A | power shift register
 | 51 | GND | GND
 | 52 | PGM_MCLR | PGM_MCLR
 | 53 | PGM_DATA_IN | PGM_DATA_IN
 | 54 | PGM_CLK_1 (SCK) | PGM_CLK
 | 55 | GND | GND
 | 56 | Reserved | Reserved
 | 57 | PGM_DATA_OUT | PGM_DATA_OUT
 | 58 | PGM_RESET | PGM_RESET
 | 59 | +5V / 250mA supply | +5V / 500mA supply
 | 60 | GND | GND
 | 61 | PGM_VCC | PGM_VCC
 |  |  |  | baud rates |  |  | terminated resistor | common mode | separate | High-level out current | Low-level out current | baud rates |  |  | terminated resistor | common mode | separate | High-level out current | Low-level out current
 | 62 | CANL / CAN_VBAT | CANL | 20k, 25k, 50k, 80k, 100k, 125k , 200k, 250k, 500k, 625k, 1M |  |  | 120 Ω | -2V to 7V | -2,5V to 7,5V | driver:- 40 mA, rec: -8mA | driver: 48 mA, rec: 8mA | 20k, 25k, 50k, 80k, 100k, 125k , 200k, 250k, 500k, 625k, 1M |  |  | 120 Ω | -2V to 7V | -2,5V to 7,5V | driver:- 40 mA, rec: -8mA | driver: 48 mA, rec: 8mA
 | 63 | CANH | CANH
 | 64 | GND | GND
zelfde | niet zeker | verschillend
 |  |  | connector D |  |  | connector E |  |  |  |  |  | connector P
 |  | pinnummer | TCC1800-UEA |  | pinnummer | TCC1800-UEA |  | pinnummer |  |  |  | TCC1800-UE | TCC1800-UEA
 |  | 1 | Reserved |  | 1 | Lock |  | 1 |  |  |  | PANEL_CLK | PANEL_CLK
 |  | 2 | Reserved |  | 2 | V out 2 |  | 2 |  |  |  | PANEL +5V | PANEL +5V
 |  | 3 | 24V AC 2b |  | 3 | V out 2 |  | 3 |  |  |  | PANEL_SDI | PANEL_SDI
 |  | 4 | 24V AC 2b |  | 4 | V out 1 |  | 4 |  |  |  | PANEL_LOAD | PANEL_LOAD
 |  | 5 | 24V AC 2a |  | 5 | V out 1 |  | 5 |  |  |  | PANEL_STROBE | PANEL_STROBE
 |  | 6 | 24V AC 2a |  | 6 | Cover Switch |  | 6 |  |  |  | PANEL_SDO | PANEL_SDO
 |  | 7 | 24V AC 1b |  | 7 | GND |  | 7 |  |  |  | +DC IN | +DC IN
 |  | 8 | 24V AC 1b |  | 8 | V sense 2 - |  | 8 |  |  |  | GND | GND
 |  | 9 | 24V AC 1a |  | 9 | V out 2 |  | 9 |  |  |  | +DC IN | +DC IN
 |  | 10 | 24V AC 1a |  | 10 | V out 2 |  | 10 |  |  |  | GND | GND
 |  | 11 | Cover Switch |  | 11 | V out 1 |  | 11 |  |  |  | +DC IN | +DC IN
 |  | 12 | Relay |  | 12 | V out 1 |  | 12 |  |  |  | GND | GND
 |  | 13 | GND |  | 13 | Relay |  | 13 |  |  |  | +DC IN | +DC IN
 |  | 14 | +27V |  | 14 | +27V |  | 14 |  |  |  | GND | GND
 |  |  |  |  | 15 | V sense 2 + |  | 15 |  |  |  | +DC IN | +DC IN
 |  |  |  |  | 16 | V out 2 |  | 16 |  |  |  | GND | GND
 |  |  |  |  | 17 | V out 2 |  | 17 |  |  |  | ETH1 TX- | ETH1 TX-
 |  |  |  |  | 18 | V out 1 |  | 18 |  |  |  | ETH1 RX- | ETH1 RX-
 |  |  |  |  | 19 | V out 1 |  | 19 |  |  |  | ETH1 TX+ | ETH1 TX+
 |  |  |  |  | 20 | V sense 1 - |  | 20 |  |  |  | ETH1 RX+ | ETH1 RX+
 |  |  |  |  | 21 | V sense 1 + |  | 21 |  |  |  | ETH2 TX- | ETH2 TX-
 |  |  |  |  |  |  |  | 22 |  |  |  | ETH2 RX- | ETH2 RX-
 |  |  |  |  |  |  |  | 23 |  |  |  | ETH2 TX+ | ETH2 TX+
 |  |  |  |  |  |  |  | 24 |  |  |  | ETH2 RX+ | ETH2 RX+
 |  |  |  |  |  |  |  | 25 |  |  |  | USB D- | USB D-
 |  |  |  |  |  |  |  | 26 |  |  |  | VBUS | VBUS
 |  |  |  |  |  |  |  | 27 |  |  |  | USB D+ | USB D+
 |  |  |  |  |  |  |  | 28 |  |  |  | USB GND | USB GND
 |  |  |  |  |  |  |  | 29 |  |  |  | !EXP_SELECT1 | !EXP_SELECT1
 |  |  |  |  |  |  |  | 30 |  |  |  | EXP_RESERVED | EXP_RESERVED
 |  |  |  |  |  |  |  | 31 |  |  |  | RESERVED_1 | RESERVED_1
 |  |  |  |  |  |  |  | 32 |  |  |  | RESERVED_2 | RESERVED_2
 |  |  |  |  |  |  |  | Note: |  |  |  | diff connectors
