justin040304/Stage-TEST-OK/afbeeldingen/Documentatiefout TCC1800-UEA ref man.PNG

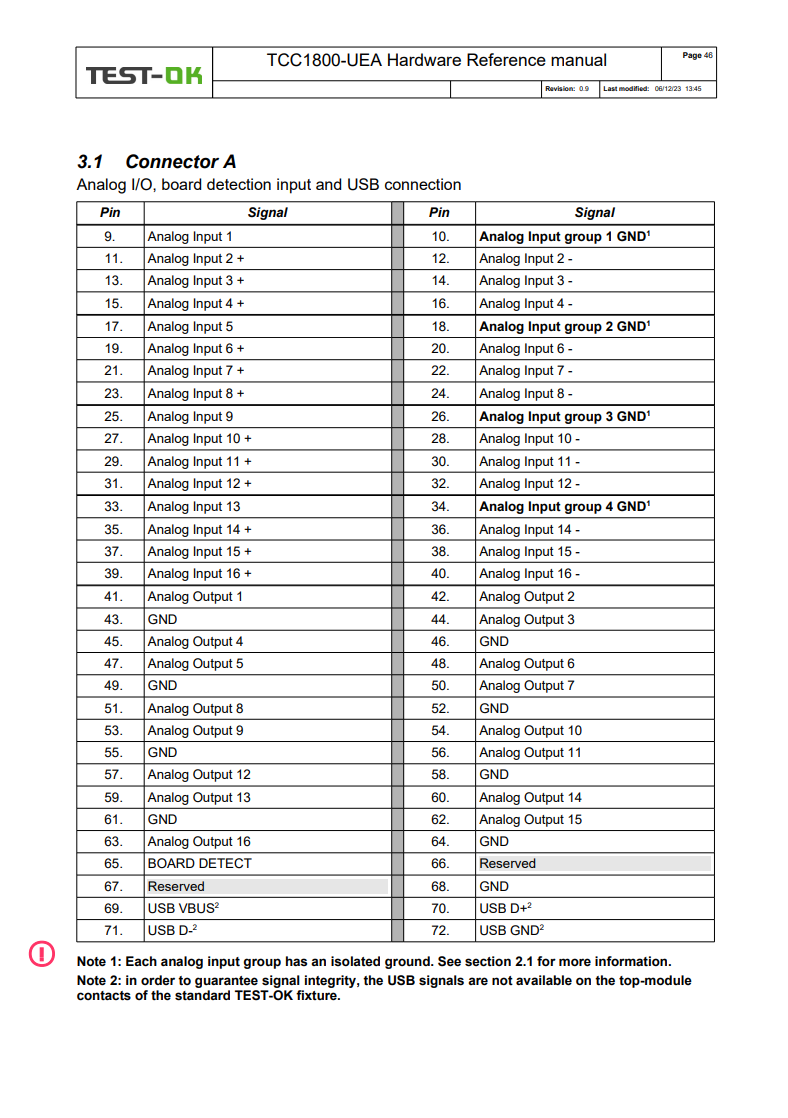
afbeeldingen/Documentatiefout TCC1800-UEA ref man.PNG
