justin040304/Stage-TEST-OK/afbeeldingen/Stage 1 planning.png

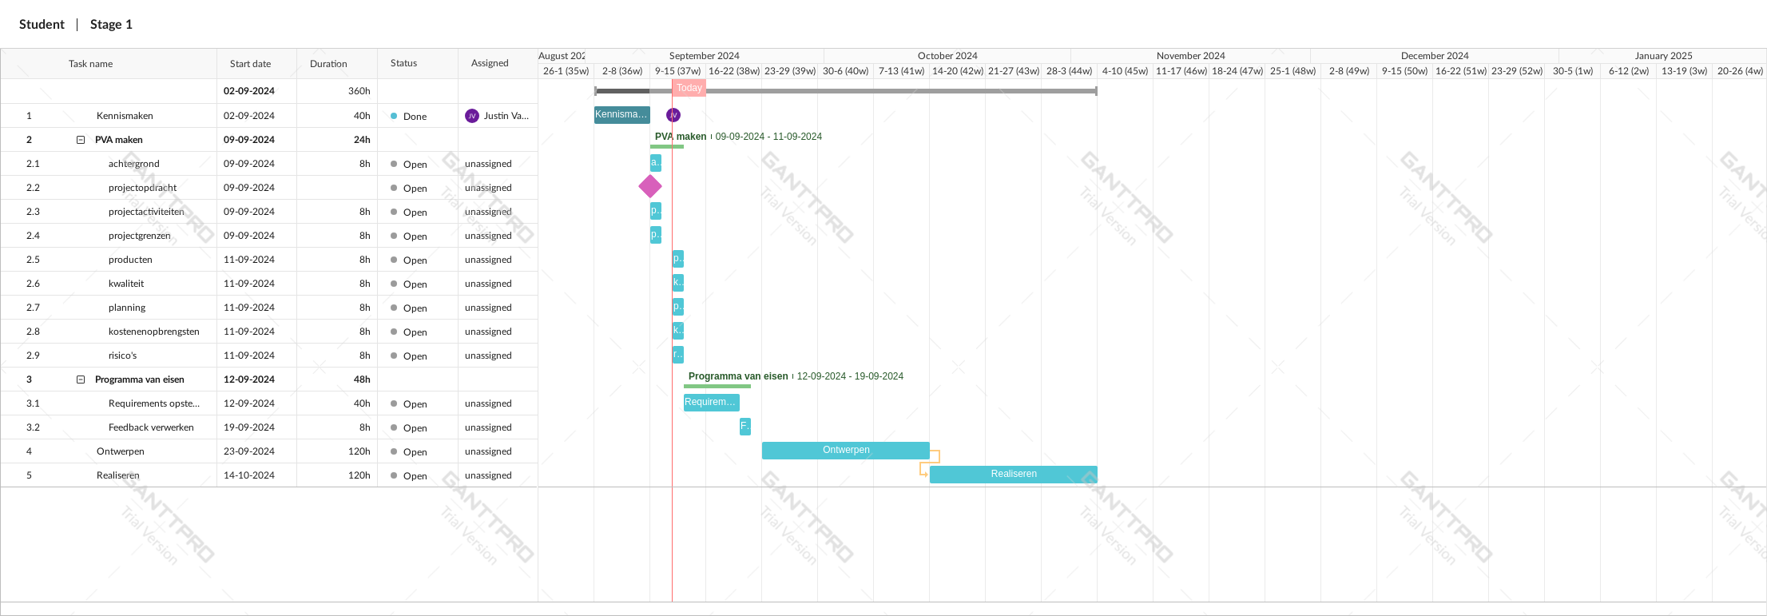
afbeeldingen/Stage 1 planning.png
