justin040304/Stage-TEST-OK/Software screenshots/Connectie tussen TCC en STM, UART/Capture.PNG

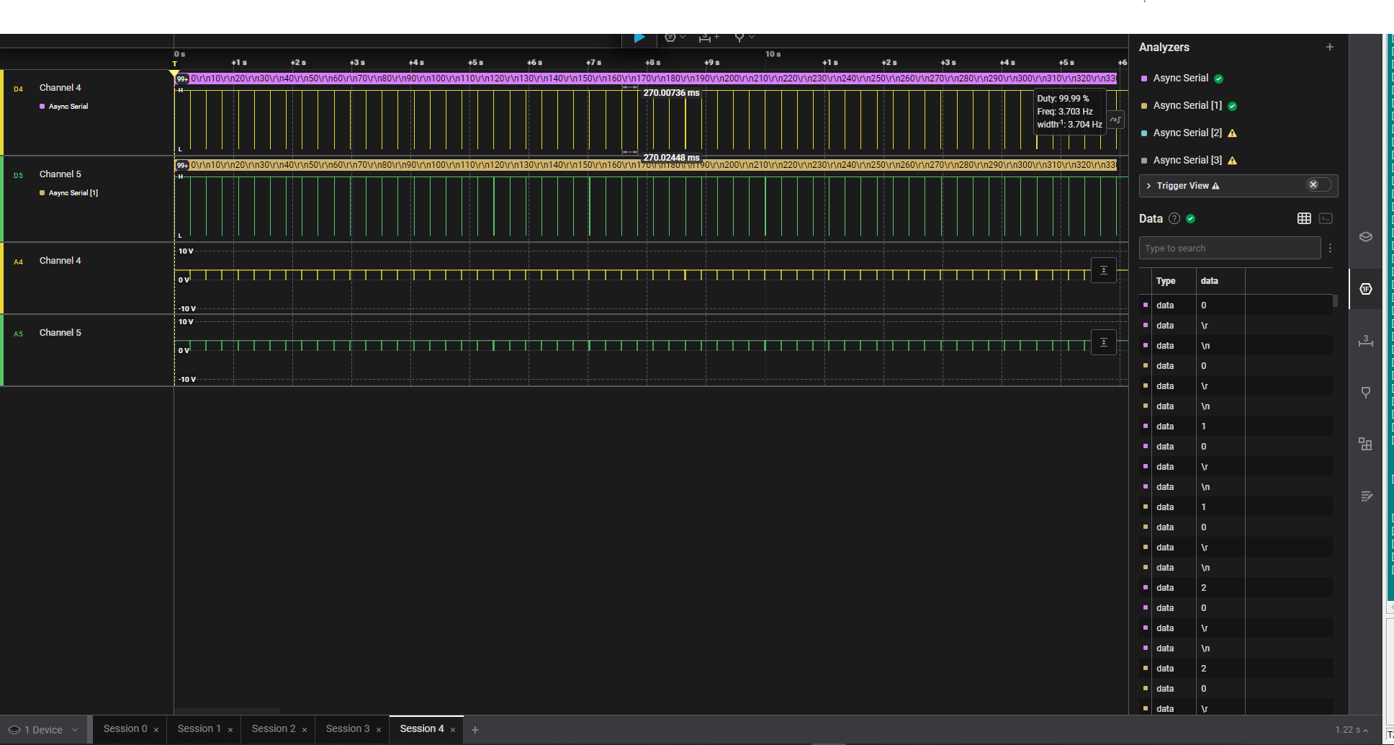
Software screenshots/Connectie tussen TCC en STM, UART/Capture.PNG
