justin040304/Stage-TEST-OK/Software screenshots/Connectie tussen TCC en STM, UART/TT script voor uart.PNG

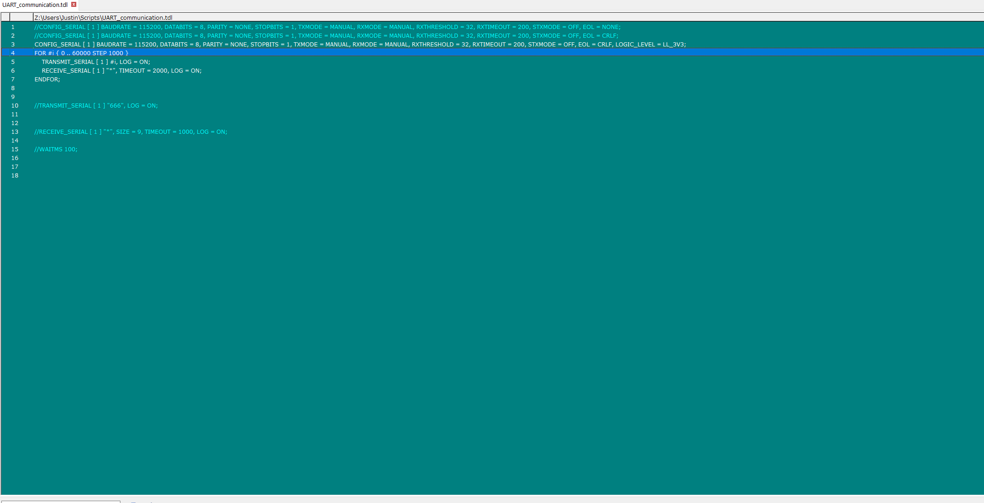
Software screenshots/Connectie tussen TCC en STM, UART/TT script voor uart.PNG
