justin040304/Stage-TEST-OK/Software screenshots/Connectie tussen TCC en STM, UART/Zend ontvangen uart.PNG

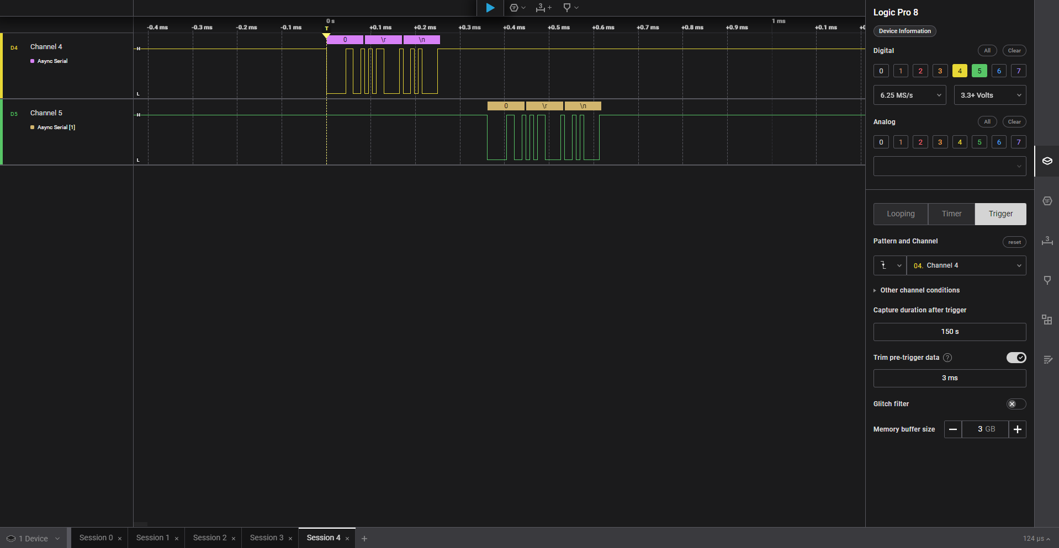
Software screenshots/Connectie tussen TCC en STM, UART/Zend ontvangen uart.PNG
