justin040304/Stage-TEST-OK/Software screenshots/SPI communicatie STM-DAC/SPI DAC writing config register example 10Mbits.PNG

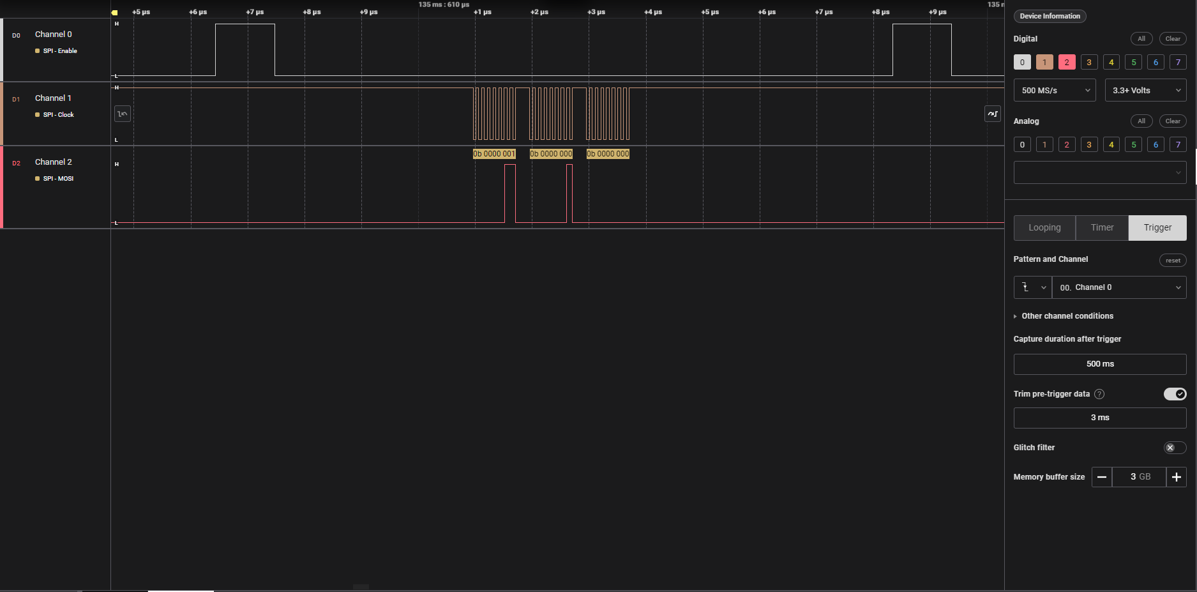
Software screenshots/SPI communicatie STM-DAC/SPI DAC writing config register example 10Mbits.PNG
