justin040304/Stage-TEST-OK/Software screenshots/SPI communicatie STM-DAC/SPI MAX4820 writing some data(5Vpos).PNG

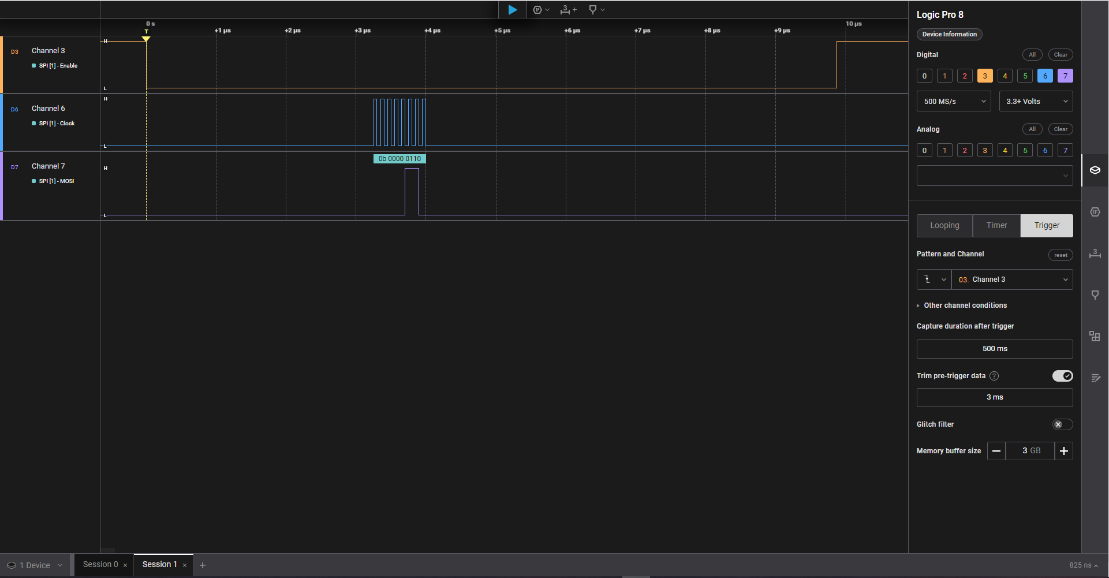
Software screenshots/SPI communicatie STM-DAC/SPI MAX4820 writing some data(5Vpos).PNG
