justin040304/Stage-TEST-OK/Test van pinnen.xlsx

TCC1800UEA |  |  |  |  |  |  | TCC1800UE
 | analog outputs type: | connector: | pin: | wat testen: | hoe testen: | waar wordt op getest: |  | analog outputs type: | connector: | pin: | wat testen: | hoe testen: | waar wordt op getest:
 | analog outputs | A | 33 tm 55 | non-linearity | ADC | 0 mA & 35 mA |  | analog outputs | A | 33 tm 55 | non-linearity | ADC | 0 mA & 35 mA
 | digital inputs type: | connector: | pin: | wat testen: | hoe testen: | waar wordt op getest: |  | digital inputs type: | connector: | pin: | wat testen: | hoe testen: | waar wordt op getest:
 | DIN schmitt trigger | C | 1 tm 26 | threshold | DAC | 0->1: 1,5V / 1 ->0: 0,75V |  | DIN schmitt trigger | C | 1 tm 26 | threshold | DAC | 0->1: 1,5V / 1 ->0: 0,75V
 | INPUT 1 | C | 1 | Counter 1: pulse & freq counter | pulsgenerator | 1kHz 2,5 MHz: |  | INPUT 1 | C | 1 | Counter 1: pulse & freq counter | pulsgenerator | tot 3 MHz
 | INPUT 2, 3, 4, 5 | C | 2 tm 5 | COUNTER 2, 3, 4, 5: Counter & pulse width | pulsgenerator | tot 200 kHz |  | INPUT 2, 3, 4, 5 | C | 2 tm 5 | COUNTER 2, 3, 4, 5: Counter & pulse width | pulsgenerator | tot 200 kHz
 | INPUT 9 |  | 9 | DI line of SPI, communicatie | microcontroller |  |  | INPUT 9 |  | 9 | DI line of SPI | microcontroller | communicatie
 | digital outputs type: | connector: | pin: | wat testen: | hoe testen: | waar wordt op getest: |  | digital outputs type: | connector: | pin: | wat testen: | hoe testen: | waar wordt op getest:
 | group 1 | B | 2 tm 9 | Non-linearity | ADC | 0 mA & 25 mA |  | group 1 | B | 2 tm 9 | Non-linearity | ADC | 0 mA & 25 mA
 | group 2, 3 | B | 11 tm 18, 20 tm 27 | Non-linearity | ADC | 0 mA & 35 mA |  | group 2, 3 | B | 11 tm 18, 20 tm 27 | Non-linearity | ADC | 0 mA & 35 mA
 | group 4 | B | 29 tm 32 | Non-linearity | ADC | 0 mA & 480 mA |  | group 4 | B | 29 tm 32 | Non-linearity | ADC | 0 mA & 480 mA
 | group 5/6 | B/C | 34 tm 41, 43 tm 50 / 5 tm 12 | GND connectie | current limiting resistor en ADC | 950 mA |  | group 5/6 | B/C | 34 tm 41, 43 tm 50 / 5 tm 12 | GND connectie | current limiting resistor en ADC
 | 2x PWM | B en C | All dig outputs | Output voltage/frequency, duty cycle, counter | ADC, freq counter, pulse width counter, number of pulses |  |  | 2x PWM | B en C | All dig outputs | Output voltage/frequency, duty cycle, counter | ADC, freq counter, pulse width counter, number of pulses
 | I2C | C | 39, 40 | Communicatie, output voltage | microcontroller slave/EEPROM | bericht ontvangen/ |  | I2C |  | 39, 40 | Communicatie, output voltage | microcontroller slave/EEPROM | bericht ontvangen/
 | UART | C | 35 en 36 | Communicatie, output voltage | microcontroller | bericht ontvangen |  | UART | C | 35 en 36 | Communicatie, output voltage | microcontroller | bericht ontvangen
 | RS485 | C | 35 en 36 | Communicatie | microcontroller, 485->232 converter | bericht ontvangen
 | SPI | B/C | 2, 3 / 11 | Communicatie | microcontroller | bericht ontvangen |  | SPI | B/C | 2, 3 / 11 | Communicatie | microcontroller | bericht ontvangen
 | CAN | B | 62 en 63 | 2-wire communicatie | microcontroller/IC | bericht ontvangen |  | CAN | B | 62 en 63 | 2-wire communicatie | microcontroller/IC | bericht ontvangen
 | Power supplies type: | connector: | pin: | wat testen: | hoe testen: | waar wordt op getest: |  | Power supplies type: | connector: | pin: | wat testen: | hoe testen: | waar wordt op getest:
 | Programmable power supplies |  |  | spanning en power consumption | spanning: ADC, pow con: stroommeter & load | spanning verloop bij verschillende load, 0 mA, 5 mA, 100 mA, 1000 m A, 1800 mA, 3000 mA |  | Programmable power supplies |  |  | spanning en power consumption | spanning: ADC, pow con: stroommeter & load | spanning verloop bij verschillende load, 0 mA, 5 mA, 100 mA, 1000 m A, 1800 mA, 3000 mA
 | Fixed voltage power supply 27V | C | 43, 44 | spanning en power consumption | spanning: ADC, pow con: stroommeter & load | spanning verloop bij verschillende load, 0 mA, 950 mA |  | Fixed voltage power supply 27V |  | 43, 44 | spanning en power consumption | spanning: ADC, pow con: stroommeter & load | spanning verloop bij verschillende load, 0 mA, 700 mA
 | Fixed voltage power supply 5V | B | 59 | spanning en power consumption | spanning: ADC, pow con: stroommeter & load | spanning verloop bij verschillende load, 0 mA, 480 mA |  | Fixed voltage power supply 5V | B | 59 | spanning en power consumption | spanning: ADC, pow con: stroommeter & load | spanning verloop bij verschillende load, 0 mA, 230 mA
 | USB type: | connector: | pin: | wat testen: | hoe testen: | waar wordt op getest: |  | USB type: | connector: | pin: | wat testen: | hoe testen: | waar wordt op getest:
 | USB | A | 61 tm 64 | Communicatie | microcontroller | bericht ontvangen |  | USB | A | 61 tm 64 | Communicatie | microcontroller | bericht ontvangen
 | Ethernet type: | connector: | pin: | wat testen: | hoe testen: | waar wordt op getest: |  | Ethernet type: | connector: | pin: | wat testen: | hoe testen: | waar wordt op getest:
 | Ethernet | C | 20 tm 27 | Communicatie |  |  |  | Ethernet | C | 20 tm 27 | Communicatie
 | Analog input type: | connector: | pin: | wat testen: | hoe testen: | waar wordt op getest: |  | Analog input type: | connector: | pin: | wat testen: | hoe testen: | waar wordt op getest:
 | differential | A | 1 tm 32
 | single ended | A | 1 tm 32
