justin040304/Stage-TEST-OK/Software screenshots/Connectie tussen TCC en STM, UART/TEST-TRACK to STM send and receive.xlsx

Sent | Received | Verschil
0 | 0 | 0
10 | 10 | 0
20 | 20 | 0
30 | 30 | 0
40 | 40 | 0
50 | 50 | 0
60 | 60 | 0
70 | 70 | 0
80 | 80 | 0
90 | 90 | 0
100 | 100 | 0
110 | 110 | 0
120 | 120 | 0
130 | 130 | 0
140 | 140 | 0
150 | 150 | 0
160 | 160 | 0
170 | 170 | 0
180 | 180 | 0
190 | 190 | 0
200 | 200 | 0
210 | 210 | 0
220 | 220 | 0
230 | 230 | 0
240 | 240 | 0
250 | 250 | 0
260 | 260 | 0
270 | 270 | 0
280 | 280 | 0
290 | 290 | 0
300 | 300 | 0
310 | 310 | 0
320 | 320 | 0
330 | 330 | 0
340 | 340 | 0
350 | 350 | 0
360 | 360 | 0
370 | 370 | 0
380 | 380 | 0
390 | 390 | 0
400 | 400 | 0
410 | 410 | 0
420 | 420 | 0
430 | 430 | 0
440 | 440 | 0
450 | 450 | 0
460 | 460 | 0
470 | 470 | 0
480 | 480 | 0
490 | 490 | 0
500 | 500 | 0
510 | 510 | 0
520 | 520 | 0
530 | 530 | 0
540 | 540 | 0
550 | 550 | 0
560 | 560 | 0
570 | 570 | 0
580 | 580 | 0
590 | 590 | 0
600 | 600 | 0
610 | 610 | 0
620 | 620 | 0
630 | 630 | 0
640 | 640 | 0
650 | 650 | 0
660 | 660 | 0
670 | 670 | 0
680 | 680 | 0
690 | 690 | 0
700 | 700 | 0
710 | 710 | 0
720 | 720 | 0
730 | 730 | 0
740 | 740 | 0
750 | 750 | 0
760 | 760 | 0
770 | 770 | 0
780 | 780 | 0
790 | 790 | 0
800 | 800 | 0
810 | 810 | 0
820 | 820 | 0
830 | 830 | 0
840 | 840 | 0
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
