justin040304/Stage-TEST-OK/Altium/DAC ADDON/Metingen kalibreren DAC ADDON.xlsx

Ideale spanning [mV] | Uitgangsspanning[mV] | a | Uitgangsspanning met curve fitting | a | Afwijking uitgangsspanning | AC Ripple[mV] | 70V supply
0 | 3 | offset | 3 | offfset | 3 | 0.16 | I[mA] | P[W] | Load | Gemeten uitgangsspanning
5000 | 5432 | 0.9204712813 | 5000.7 | 1.00014 | 0.7 | 0.64
10000 | 10864 | 0.9204712813 | 10000.4 | 1.00004 | 0.4 | 0.7
15000 | 16295 | 0.9205277693 | 14999.7 | 0.99998 | -0.3 | 0.76
20000 | 21727 | 0.9205136466 | 20000 | 1 | 0 | 0.82
25000 | 27158 | 0.9205390677 | 25000 | 1 | 0 | 0.9
30000 | 32590 | 0.9205277693 | 29999.6 | 0.9999866667 | -0.4 | 0.95
35000 | 38021 | 0.9205439099 | 34999.4 | 0.9999828571 | -0.6 | 1.03
40000 | 43453 | 0.9205348307 | 40000.1 | 1.0000025 | 0.1 | 1.09
45000 | 48885 | 0.9205277693 | 45000 | 1 | 0 | 1.16
50000 | 54316 | 0.9205390677 | 50000.1 | 1.000002 | 0.1 | 1.24
55000 | 59748 | 0.9205329049 | 55000.7 | 1.000012727 | 0.7 | 1.31
60000 | 65181 | 0.9205136466 | 60001.5 | 1.000025 | 1.5 | 1.38
