justin040304/Stage-TEST-OK/Software screenshots/Connectie tussen TCC en STM, UART/TT test passed.PNG

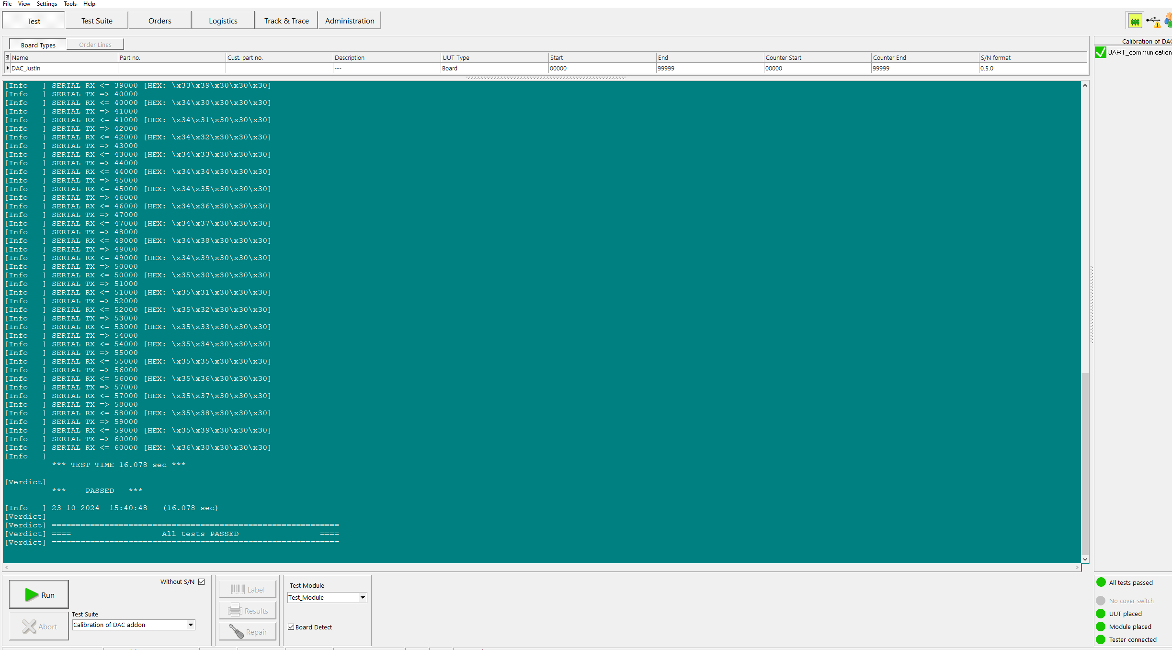
Software screenshots/Connectie tussen TCC en STM, UART/TT test passed.PNG
