justin040304/Stage-TEST-OK/Altium/DAC ADDON/Boost converter/WBDesign16_Load Transient-4.pdf

## WEBENCH ® Design Report

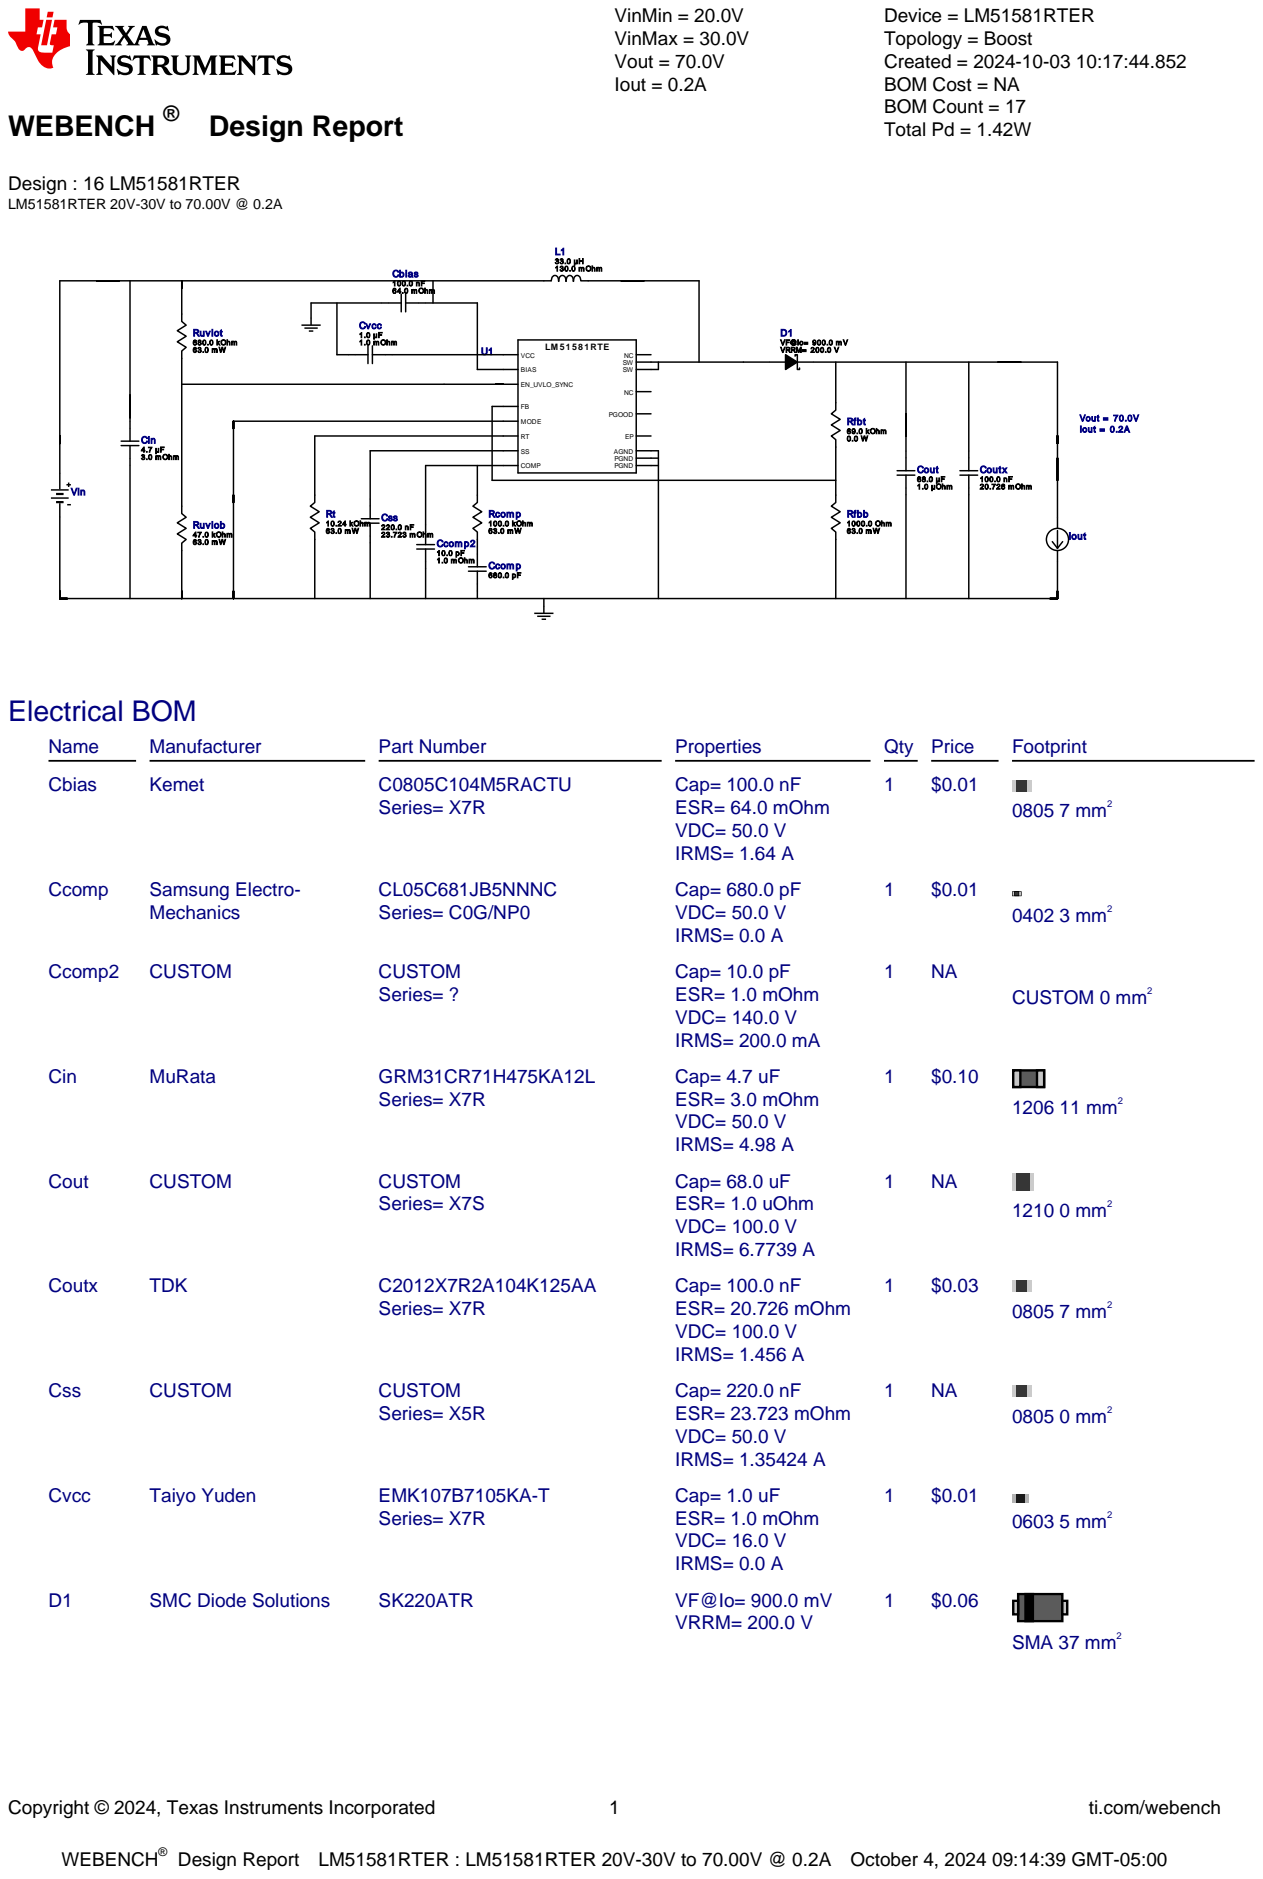
[picture p13: page 1]
Copyright © 2024, Texas Instruments Incorporated; ti.com/webench; WEBENCH®; Design : 16 LM51581RTER LM51581RTER 20V-30V to 70.00V @ 0.2A; VinMin = 20.0V VinMax = 30.0V Vout = 70.0V Iout = 0.2A; Ccom p 680.0 pF; LM 5 1 5 8 1 RTE; PGND; VCC; BIAS; PGOOD; EN_UVLO_SYNC; AGND; COMP; MODE; Rcom p 100.0 kOhm 63.0 m W Ruvlob 47.0 kOhm 63.0 m W; Ruvlot 680.0 kOhm; Vout = 70.0V Iout = 0.2A; Cbias 100.0 nF 64.0 m Ohm; Cout 68.0 µF; 1.0 µOhm; Coutx 100.0 nF 20.726 m Ohm; Ccom p2 10.0 pF 1.0 m Ohm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

Device = LM51581RTER
Topology = Boost
Created = 2024-10-03 10:17:44.852
BOM Cost = NA
BOM Count = 17
Total Pd = 1.42W

Design Report LM51581RTER : LM51581RTER 20V-30V to 70.00V @ 0.2A October 4, 2024 09:14:39 GMT-05:00

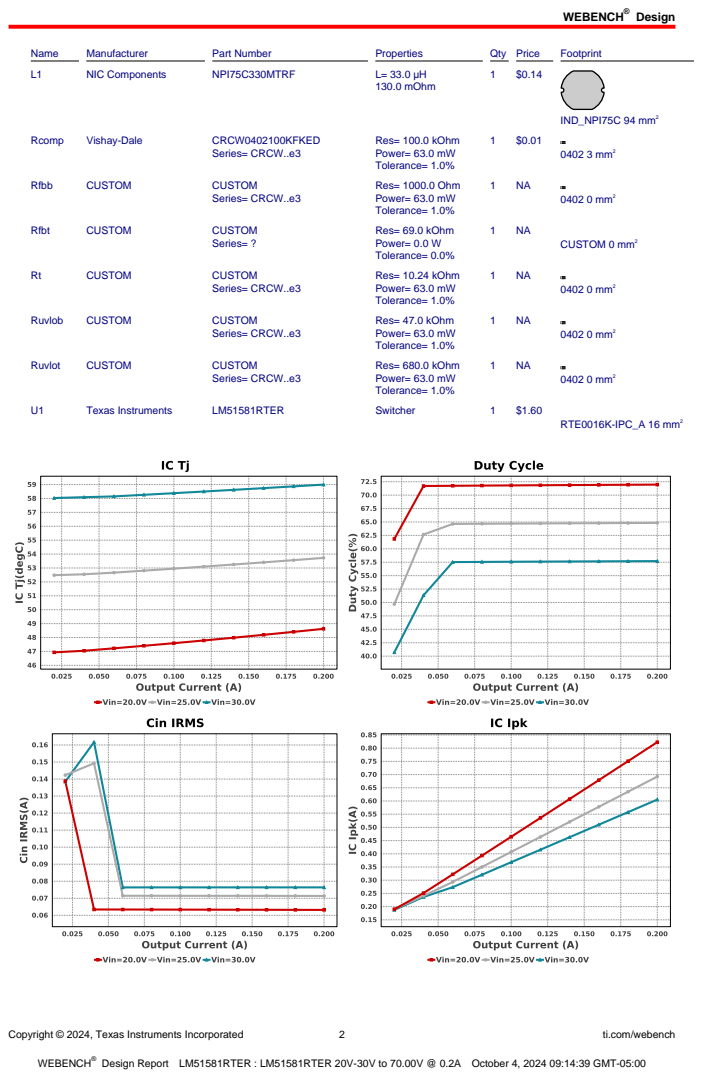
[picture p14: page 2]
Design; Copyright © 2024, Texas Instruments Incorporated; ti.com/webench; Name; Manufacturer; Part Number; Properties; Qty Price; Footprint; NIC Components; NPI75C330MTRF; 130.0 mOhm; IND_NPI75C 94 mm²; Rcomp; Vishay-Dale; CRCW0402100KFKED; Series= CRCW..e3; Res= 100.0 kOhm Power= 63.0 mW Tolerance= 1.0%; 0402 3 mm²; Rfbb; CUSTOM; Res= 1000.0 Ohm Power= 63.0 mW Tolerance= 1.0%; 0402 0 mm²; Rfbt; Series= ?; Res= 69.0 kOhm Power= 0.0 W Tolerance= 0.0%; CUSTOM 0 mm²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

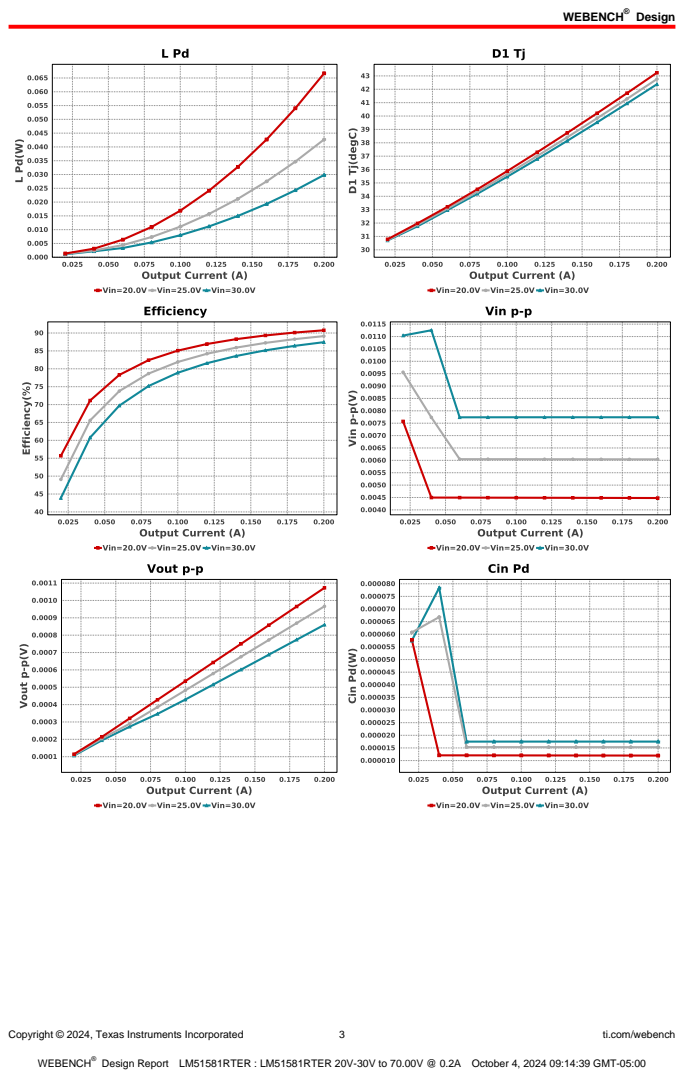
[picture p15: page 3]
Copyright © 2024, Texas Instruments Incorporated; ti.com/webench

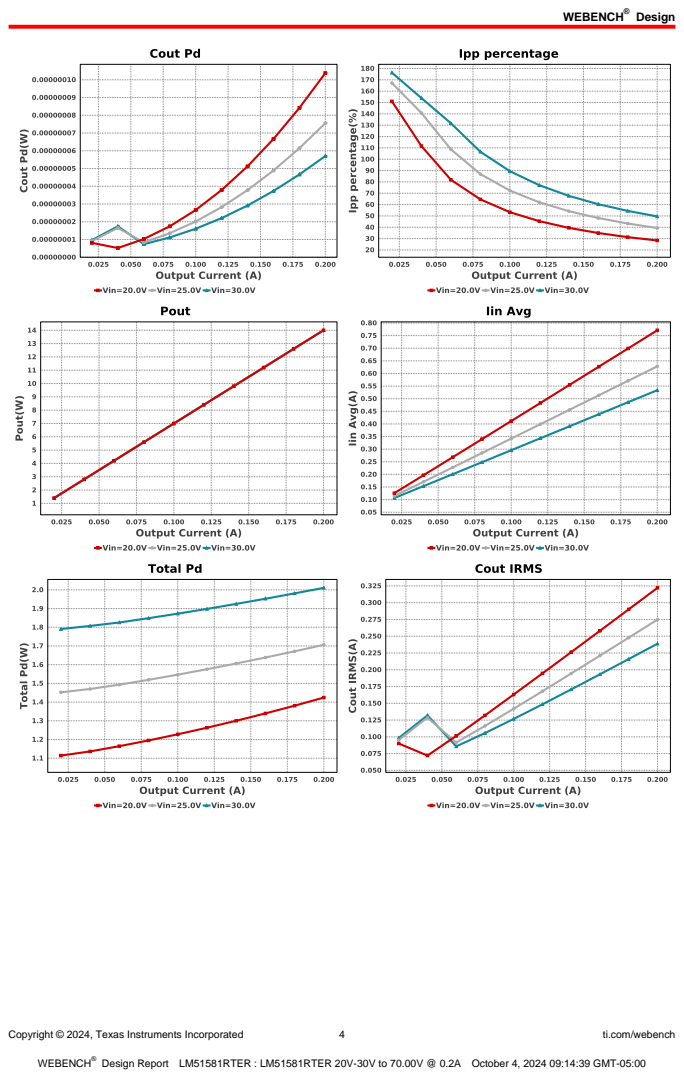
[picture p16: page 4]
Copyright © 2024, Texas Instruments Incorporated; ti.com/webench

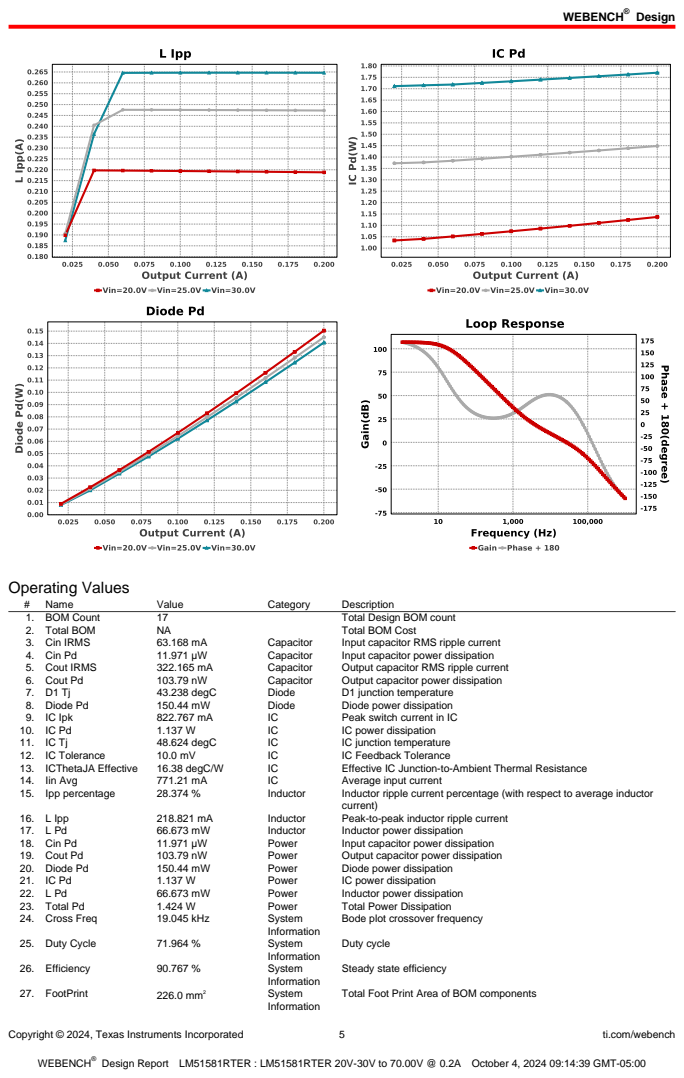
[picture p17: page 5]
Copyright © 2024, Texas Instruments Incorporated; ti.com/webench; Operating Values; Name; Value; Category; Description; 1. BOM Count; Total Design BOM count; 2. Total BOM; Total BOM Cost; 3. Cin IRMS; Capacitor; Input capacitor RMS ripple current; 4. Cin Pd; Input capacitor power dissipation; 5. Cout IRMS; Output capacitor RMS ripple current; 6. Cout Pd; Output capacitor power dissipation; 43.238 degC; Diode; D1 junction temperature; 8. Diode Pd; Diode power dissipation; 9. IC Ipk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

Bode plot crossover frequency

Steady state efficiency

Total Foot Print Area of BOM components

Copyright © 2024, Texas Instruments Incorporated | 6 | ti.com/webench
# | Name | Value | Category | Description

28. Frequency | 1.974 MHz | System
| | | Information | Switching frequency
29. Gain Marg | -12.4 dB | System
| | | Information | Bode Plot Gain Margin
30. Iout | 200.0 mA | System
| | | Information | Iout operating point
31. Low Freq Gain | 103.504 dB | System
| | | Information | Gain at 1Hz
32. Mode | CCM | System
| | | Information | Conduction Mode
33. Phase Marg | 52.586 deg | System
| | | Information | Bode Plot Phase Margin
34. Pout | 14.0 W | System
| | | Information | Total output power
35. Vin | 20.0 V | System
| | | Information | Vin operating point
36. Vin p-p | 4.479 mV | System
| | | Information | Input Source ripple voltage
37. Vout | 70.0 V | System
| | | Information | Operational Output Voltage
38. Vout Actual | 70.0 V | System
| | | Information | Vout Actual calculated based on selected voltage divider resistors
39. Vout Tolerance | 2.006 % | System
| | | Information | Vout Tolerance based on IC Tolerance (no load) and voltage divider
| | | | resistors if applicable
40. Vout p-p | 1.073 mV | System
| | | Information | Peak-to-peak output ripple voltage

## Design Inputs

Name | Value | Description
| Iout | | 200.0 m | Maximum Output Current
| SoftStart | | 10.0 ms | Soft Start Time (ms)
VinMax | 30.0 | Maximum input voltage
VinMin | 20.0 | Minimum input voltage
Vout | 70.0 | Output Voltage
| base_pn | | LM51581 | Base Product Number
source | DC | Input Source Type
Ta | 30.0 | Ambient temperature
| UserFsw | | 2.017 M | Customer Selected Frequency


Copyright © 2024, Texas Instruments Incorporated | 7 | ti.com/webench

## Assembly

## Component Testing

Some published data on components in datasheets such as Capacitor ESR and Inductor DC resistance is based on conservative values that will guarantee that the components always exceed the specification. For design purposes it is usually better to work with typical values. Since this data is not always available it is a good practice to measure the Capacitance and ESR values of Cin and Cout, and the inductance and DC resistance of L1 before assembly of the board. Any large discrepancies in values should be electrically simulated in WEBENCH to check for instabilities and thermally simulated in WebTHERM to make sure critical temperatures are not exceeded.

## Soldering Component to Board

If board assembly is done in house it is best to tack down one terminal of a component on the board then solder the other terminal. For surface mount parts with large tabs, such as the DPAK, the tab on the back of the package should be pre-tinned with solder, then tacked into place by one of the pins. To solder the tab town to the board place the iron down on the board while resting against the tab, heating both surfaces simultaneously. Apply light pressure to the top of the plastic case until the solder flows around the part and the part is flush with the PCB. If the solder is not flowing around the board you may need a higher wattage iron (generally 25W to 30W is enough).

## Initial Startup of Circuit

It is best to initially power up the board by setting the input supply voltage to the lowest operating input voltage 20.0V and set the input supply's current limit to zero. With the input supply off connect up the input supply to Vin and GND. Connect a digital volt meter and a load if needed to set the minimum Iout of the design from Vout and GND. Turn on the input supply and slowly turn up the current limit on the input supply.
If the voltage starts to rise on the input supply continue increasing the input supply current limit while watching the output voltage. If the current increases on the input supply, but the voltage remains near zero, then there may be a short or a component misplaced on the board. Power down the board and visually inspect for solder bridges and recheck the diode and capacitor polarities. Once the power supply circuit is operational then more extensive testing may include full load testing, transient load and line tests to compare with simulation results.

## Load Testing

The setup is the same as the initial startup, except that an additional digital voltmeter is connected between Vin and GND, a load is connected between Vout and GND and a current meter is connected in series between Vout and the load. The load must be able to handle at least rated output power + 50% ( 7.5 watts for this design). Ideally the load is supplied in the form of a variable load test unit. It can also be done in the form of suitably large power resistors. When using an oscilloscope to measure waveforms on the prototype board, the ground leads of the oscilloscope probes should be as short as possible and the area of the loop formed by the ground lead should be kept to a minimum. This will help reduce ground lead inductance and eliminate EMI noise that is not actually present in the circuit.

## WEBENCH® Electrical Simulation Report

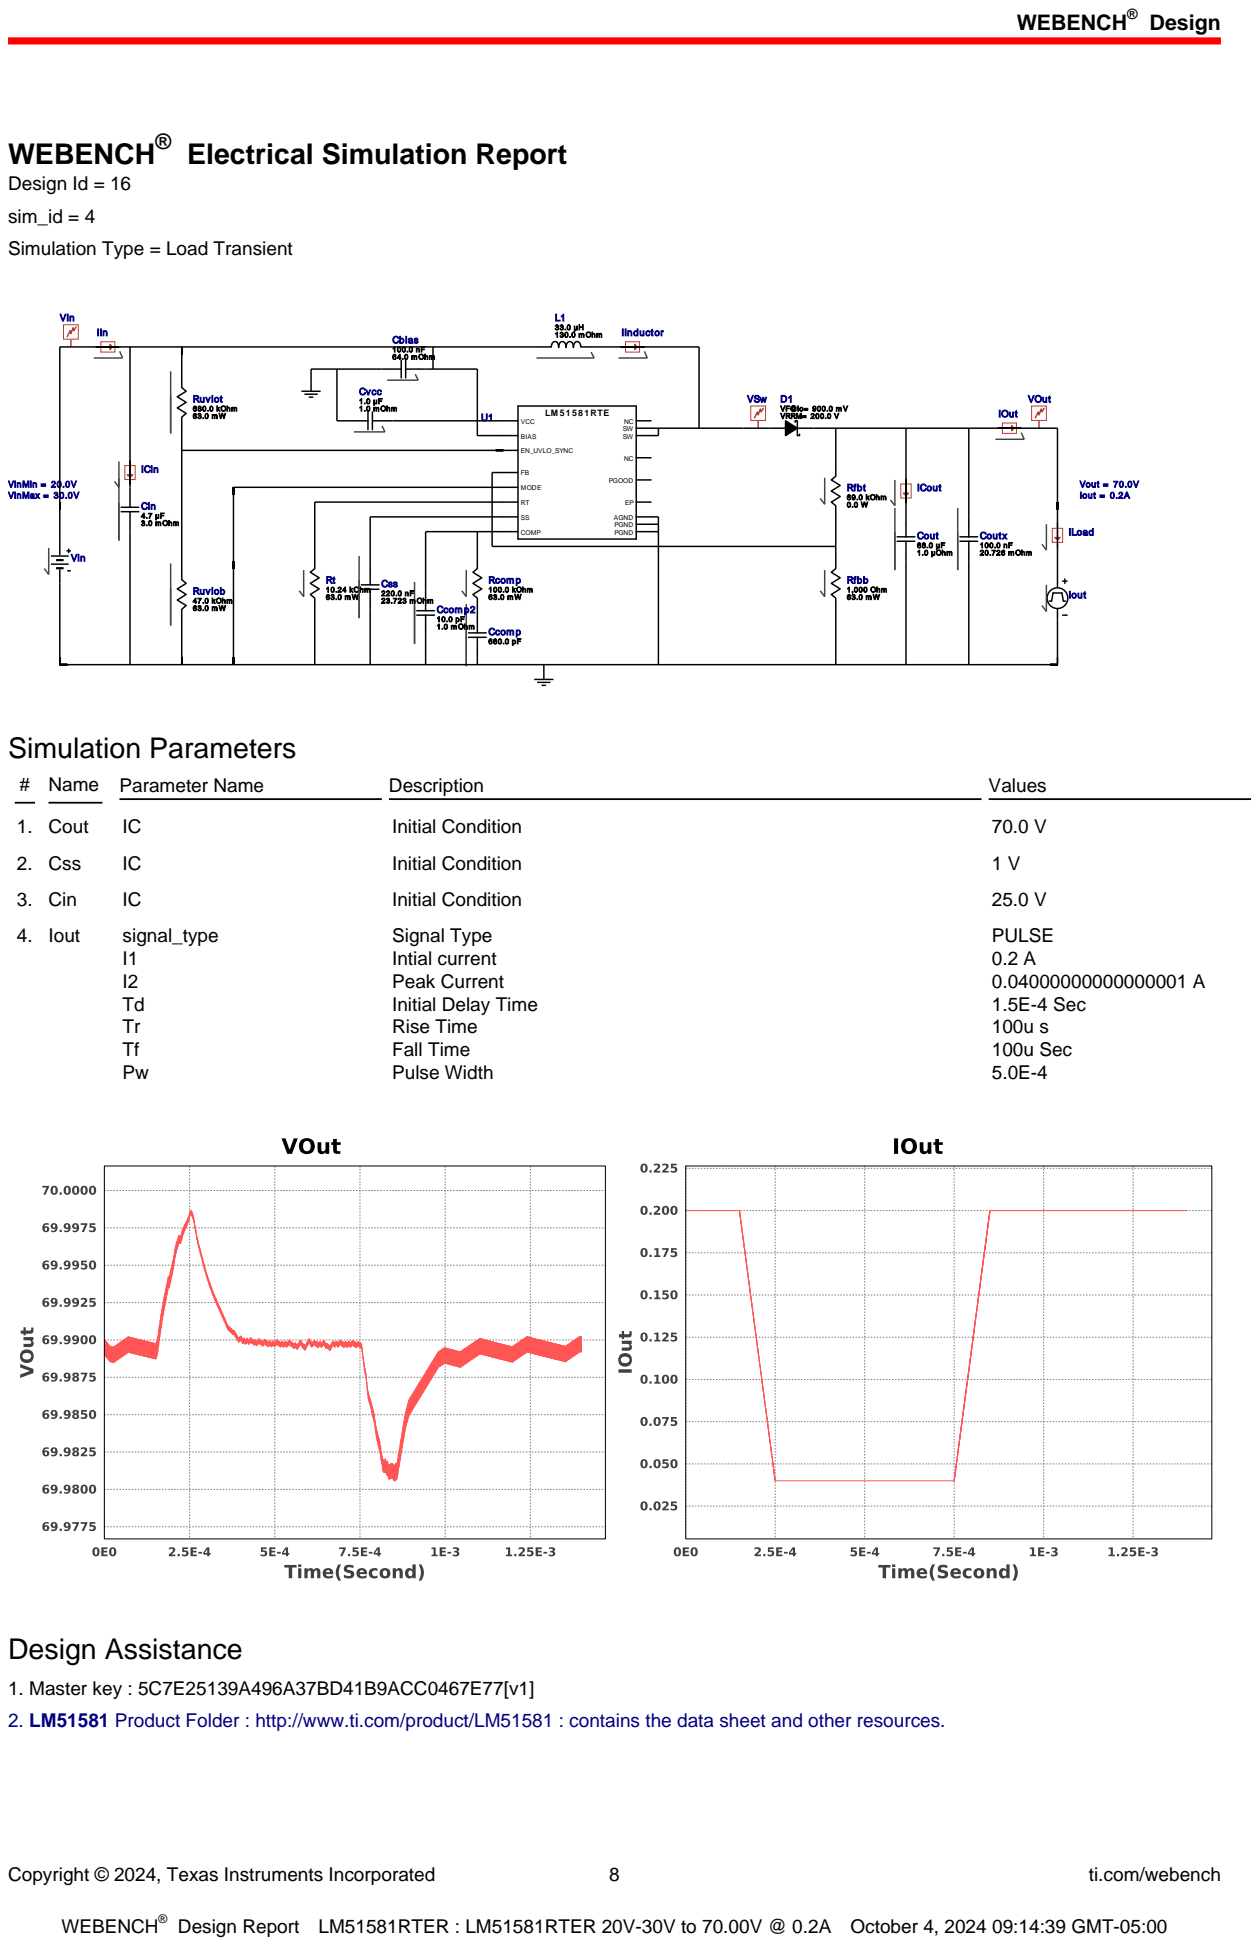
[picture p19: page 8]
Copyright © 2024, Texas Instruments Incorporated; ti.com/webench; Ccom p 680.0 pF; LM 5 1 5 8 1 RTE; PGND; VCC; BIAS; PGOOD; EN_UVLO_SYNC; AGND; COMP; MODE; Rcom p 100.0 kOhm 63.0 m W Ruvlob 47.0 kOhm 63.0 m W; Ruvlot 680.0 kOhm; IInductor; Vout = 70.0V Iout = 0.2A; VOut; Cbias 100.0 nF 64.0 m Ohm; Cout 68.0 µF; 1.0 µOhm; IIn; ICin; Coutx 100.0 nF 20.726 m Ohm; Ccom p2 10.0 pF 1.0 m Ohm; VinMin = 20.0V VinMax = 30.0V; VIn; VRRM= 200.0 V; IOut; VSw; ICout; Cvcc 1.0 µF 1.0 m Ohm; Rt 10.24 kOhm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

Design Id = 16
sim_id = 4
Simulation Type = Load Transient

1. Master key : 5C7E25139A496A37BD41B9ACC0467E77[v1]
2. LM51581 Product Folder : http://www.ti.com/product/LM51581 : contains the data sheet and other resources.

Copyright © 2024, Texas Instruments Incorporated | 9 | ti.com/webench

Important Notice and Disclaimer

TI provides technical and reliability data (including datasheets), design resources (including reference designs), application or other design advice, web tools, safety information, and other resources AS IS and with all faults, and disclaims all warranties. These resources are intended for skilled developers designing with TI products. You are solely responsible for (1) selecting the appropriate TI products for your application, (2) designing, validating and testing your application, and (3) ensuring your application meets applicable standards, and any other safety, security, or other requirements.

These resources are subject to change without notice. TI grants you permission to use these resources only for development of an application that uses the TI products described in the resource. Other reproduction and display of these resources is prohibited. No license is granted to any other TI intellectual property right or to any third party intellectual property right. TI disclaims responsibility for, and you will fully indemnify TI and its representatives against, any claims, damages, costs, losses, and liabilities arising out of your use of these resources.

Providing these resources does not expand or otherwise alter TI's applicable Terms of Sale or other applicable terms available either on ti.com or provided in conjunction with TI products.
