justin040304/Stage-TEST-OK/Altium/DAC ADDON/Simulatie LTC6090/Draft1.asc

C1: cap; 2.2µ; Rser=10m
C2: cap; 20µ
L1: ind; 60µ; Rser=1
L2: ind; 1µ; Rser=150m
V1: voltage; SINE(1 1 1000k); AC 1
Named nets: 0, Out, in
;ac dec 1m 1 10Meg
.tran 1m
