justin040304/Stage-TEST-OK/Altium/DAC ADDON/Simulatie LTC6090/LTC6090.asc

C1: cap; 300p
C2: cap; 100p
C3: cap; 270p
R1: res; 4k7
R2: res; 51.7k
R6: res; 7.5Meg
R7: res; 330k
Rcomp: res; 4300
Rf: res; 51.7k
Ri: res; 4k7
U1: LTC6090
U3: LTC6090
V1: voltage; -5
V2: voltage; 5; AC 1
V3: voltage; 70
V4: voltage; 1; AC 1
Named nets: 0, -V, +V, OUT, Vout2, IN, fb
;tran 80m
.dc dec V2 0 10 1m
.noise V(n002) V2 dec 5 1 1Meg
;ac dec 100 1 10Meg
;dc V2 1m 5 100
