justin040304/Stage-TEST-OK/(list of files, drawings)

Other design files:
Altium/stage test/stage test.PrjPcb
kalibratiemodule EAGLE/Imported Relay_Addon_Board.PrjPcb/Relay_Addon_Board.PcbDoc
kalibratiemodule EAGLE/Imported Relay_Addon_Board.PrjPcb/Relay_Addon_Board.PrjPcb
kalibratiemodule EAGLE/Imported Relay_Addon_Board.PrjPcb/Relay_Addon_Board.SchDoc
kalibratiemodule EAGLE/Imported TCC Tester - TCC1800UE Connector Board 3x96 BOTTOM V2.0.PrjPcb/Analog-IN Relays.SchDoc
kalibratiemodule EAGLE/Imported TCC Tester - TCC1800UE Connector Board 3x96 BOTTOM V2.0.PrjPcb/Analog-OUT Relays.SchDoc
kalibratiemodule EAGLE/Imported TCC Tester - TCC1800UE Connector Board 3x96 BOTTOM V2.0.PrjPcb/Beamstrip.SchDoc
kalibratiemodule EAGLE/Imported TCC Tester - TCC1800UE Connector Board 3x96 BOTTOM V2.0.PrjPcb/CAN - UART transceiver.SchDoc
kalibratiemodule EAGLE/Imported TCC Tester - TCC1800UE Connector Board 3x96 BOTTOM V2.0.PrjPcb/Counters.SchDoc
kalibratiemodule EAGLE/Imported TCC Tester - TCC1800UE Connector Board 3x96 BOTTOM V2.0.PrjPcb/Digital-IN Relays (9..20) .SchDoc
kalibratiemodule EAGLE/Imported TCC Tester - TCC1800UE Connector Board 3x96 BOTTOM V2.0.PrjPcb/Digital-OUT (Group 4) + SPI relays .SchDoc
kalibratiemodule EAGLE/Imported TCC Tester - TCC1800UE Connector Board 3x96 BOTTOM V2.0.PrjPcb/Digital-OUT (Group 5) & Digital-IN (1..9) & Digital-OUT (Group 6).SchDoc
kalibratiemodule EAGLE/Imported TCC Tester - TCC1800UE Connector Board 3x96 BOTTOM V2.0.PrjPcb/Digital-OUT Relays (Group 1,2,3) .SchDoc
kalibratiemodule EAGLE/Imported TCC Tester - TCC1800UE Connector Board 3x96 BOTTOM V2.0.PrjPcb/Expansion.SchDoc
kalibratiemodule EAGLE/Imported TCC Tester - TCC1800UE Connector Board 3x96 BOTTOM V2.0.PrjPcb/I2C devices.SchDoc
kalibratiemodule EAGLE/Imported TCC Tester - TCC1800UE Connector Board 3x96 BOTTOM V2.0.PrjPcb/IO-expanders.SchDoc
kalibratiemodule EAGLE/Imported TCC Tester - TCC1800UE Connector Board 3x96 BOTTOM V2.0.PrjPcb/Microcontroller.SchDoc
kalibratiemodule EAGLE/Imported TCC Tester - TCC1800UE Connector Board 3x96 BOTTOM V2.0.PrjPcb/Module ID.SchDoc
kalibratiemodule EAGLE/Imported TCC Tester - TCC1800UE Connector Board 3x96 BOTTOM V2.0.PrjPcb/Power supply Relays .SchDoc
kalibratiemodule EAGLE/Imported TCC Tester - TCC1800UE Connector Board 3x96 BOTTOM V2.0.PrjPcb/Power supply.SchDoc
kalibratiemodule EAGLE/Imported TCC Tester - TCC1800UE Connector Board 3x96 BOTTOM V2.0.PrjPcb/Precidip.SchDoc
kalibratiemodule EAGLE/Imported TCC Tester - TCC1800UE Connector Board 3x96 BOTTOM V2.0.PrjPcb/Programmer.SchDoc
kalibratiemodule EAGLE/Imported TCC Tester - TCC1800UE Connector Board 3x96 BOTTOM V2.0.PrjPcb/PWM, Board detect & Cover switch .SchDoc
kalibratiemodule EAGLE/Imported TCC Tester - TCC1800UE Connector Board 3x96 BOTTOM V2.0.PrjPcb/SPI devices.SchDoc
kalibratiemodule EAGLE/Imported TCC Tester - TCC1800UE Connector Board 3x96 BOTTOM V2.0.PrjPcb/Switching connectors DMM & Power supply .SchDoc
kalibratiemodule EAGLE/Imported TCC Tester - TCC1800UE Connector Board 3x96 BOTTOM V2.0.PrjPcb/TCC Tester - TCC1800UE Connector Board 3x96 BOTTOM V2.0.PrjPcb
kalibratiemodule EAGLE/Imported TCC Tester - TCC1800UE Connector Board 3x96 BOTTOM V2.0.PrjPcb/TCC Tester - TCC1800UE Connector Board 3x96 BOTTOM V2.0_22.SchDoc
kalibratiemodule EAGLE/Imported TCC Tester - TCC1800UE Connector Board 3x96 BOTTOM V2.0.PrjPcb/UART devices.SchDoc
