justin040304/Stage-TEST-OK/Altium/DAC ADDON/ST Software/DAC80501 aansturing/Core/Src/main.c

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
/* Includes ------------------------------------------------------------------*/
#include "main.h"

/* USER CODE BEGIN Includes */
#include "stm32l4xx_hal.h"
/* USER CODE END Includes */

/* USER CODE BEGIN PTD */
extern SPI_HandleTypeDef hspi1;  // De SPI interface die we gebruiken
/* USER CODE END PTD */

/* USER CODE BEGIN PD */




//Registers adres definitie van de DAC80501
#define ADDR_NOOP_register 0b00000000 //No operation, Hex 0x00
#define ADDR_DEVID_register 0b00000001 //Device identification, Hex 0x01
#define ADDR_SYNC_register 0b0000 0010 //Synchronisation, Hex 0x02
#define ADDR_CONFIG_register 0b00000011 //Configuration, Hex 0x03
#define ADDR_GAIN_register 0b00000100 //Gain, Hex 0x04
#define ADDR_TRIGGER_register 0b00000101 //Trigger, Hex 0x05
#define ADDR_STATUS_register 0b00000111 //Status, Hex 0x07
#define ADDR_DAC_DATA_register 0b00001000 //Digital-to-analog converter, Hex 0x08

//Register Data van de DAC80501
#define DATA_NOOP 0x00
	//#define DATA_DEVID_register 0b0000 0001 0001 0101, kan worden uitgelezen
#define DATA_SYNC_register 0x00
#define DATA_CONFIG_register 0b0000000100000000 //disabling internal reference & power-down mode
#define DATA_GAIN_register 0x00 //referencespanning delen door 1 & gain op 1 zetten
#define DATA_TRIGGER_register 0x0A //dit reset de dac  & zet de dac in asynchronous mode(default)
	//#define DATA_STATUS_register 0x01 geeft aan of DAC wordt uitgeschakeld, 0x00 geeft aan dat dac is ingeschakeld
#define DAC80501_SPI_TIMEOUT 100



//SS pin van de DAC, verander zonodig
#define DAC_SS_Pin GPIO_PIN_6
#define DAC_SS_Port GPIOB




/* USER CODE END PD */

SPI_HandleTypeDef hspi1;

UART_HandleTypeDef huart2;

/* USER CODE BEGIN PV */
uint8_t DacAdres = 0b10010010;
uint16_t DATA__DAC_DATA_register;




HAL_StatusTypeDef check;

//stuur eerst DACadres, Register adres en dan data respectievelijk

/* USER CODE END PV */

void SystemClock_Config(void);
static void MX_GPIO_Init(void);
static void MX_USART2_UART_Init(void);
static void MX_SPI1_Init(void);
/* USER CODE BEGIN PFP */



HAL_StatusTypeDef DAC80501Reset(void)
{
    HAL_StatusTypeDef status;
    uint8_t txData[3];

    // Stel het adres en de data in voor het trigger-register van de DAC80501
    txData[0] = ADDR_TRIGGER_register;                     // Registeradres
    txData[1] = (DATA_TRIGGER_register >> 8 ) & 0xFF;      // MSB van de 16-bits data
    txData[2] = (DATA_TRIGGER_register & 0xFF);              // LSB van de 16-bits data

    // Zet de Chip Select (CS/SS) lijn laag om SPI-communicatie te starten
    HAL_GPIO_WritePin(DAC_SS_Port, DAC_SS_Pin, GPIO_PIN_RESET);

    // Verzend de 24-bits data via SPI
    status = HAL_SPI_Transmit(&hspi1, txData, 3, DAC80501_SPI_TIMEOUT);

    // Zet de Chip Select (CS/SS) lijn hoog om SPI-communicatie te beëindigen
    HAL_GPIO_WritePin(DAC_SS_Port, DAC_SS_Pin, GPIO_PIN_SET);

    // Retourneer de status van de SPI-communicatie (HAL_OK of foutcode)
    return status;
}

HAL_StatusTypeDef DAC80501Config(void)
{
	 HAL_StatusTypeDef status;
	 uint8_t txData[3];

	 txData[0] =  ADDR_CONFIG_register;                     // Registeradres
	 txData[1] = (DATA_CONFIG_register >> 8 ) & 0xFF;      // MSB van de 16-bits data
	 txData[2] = (DATA_CONFIG_register & 0xFF);              // LSB van de 16-bits data

	 // Zet de Chip Select (CS/SS) lijn laag om SPI-communicatie te starten
	 HAL_GPIO_WritePin(DAC_SS_Port, DAC_SS_Pin, GPIO_PIN_RESET);

	 // Verzend de 24-bits data via SPI
	 status = HAL_SPI_Transmit(&hspi1, txData, 3, DAC80501_SPI_TIMEOUT);

	 // Zet de Chip Select (CS/SS) lijn hoog om SPI-communicatie te beëindigen
	 HAL_GPIO_WritePin(DAC_SS_Port, DAC_SS_Pin, GPIO_PIN_SET);

	 // Retourneer de status van de SPI-communicatie (HAL_OK of foutcode)
	 return status;
}

HAL_StatusTypeDef DAC80501Gain(void)
{
	 HAL_StatusTypeDef status;
	 uint8_t txData[3];

	 txData[0] = ADDR_GAIN_register ;                     // Registeradres
	 txData[1] = (DATA_GAIN_register >> 8 ) & 0xFF;      // MSB van de 16-bits data
	 txData[2] = (DATA_GAIN_register & 0xFF);              // LSB van de 16-bits data

	 // Zet de Chip Select (CS/SS) lijn laag om SPI-communicatie te starten
	 HAL_GPIO_WritePin(DAC_SS_Port, DAC_SS_Pin, GPIO_PIN_RESET);

	 // Verzend de 24-bits data via SPI
	 status = HAL_SPI_Transmit(&hspi1, txData, 3, DAC80501_SPI_TIMEOUT);

	 // Zet de Chip Select (CS/SS) lijn hoog om SPI-communicatie te beëindigen
	 HAL_GPIO_WritePin(DAC_SS_Port, DAC_SS_Pin, GPIO_PIN_SET);

	 // Retourneer de status van de SPI-communicatie (HAL_OK of foutcode)
	 return status;
}

HAL_StatusTypeDef DAC80501DataVoltage5V(uint16_t voltage_mV)  //data(getal) moet in mV zijn van 0 tot 5000mV
{
	//Zorgen dat spanning tussen 0-5000mV zit
	if(voltage_mV > 5000){ //Houdt de spanning onder de 5000mV
		voltage_mV = 5000;
	}
	if(voltage_mV < 0){ //Houdt de spanning boven de 0mV. Werkt niet goed vanwerge unsigned naar signed conversion bij functie aanroep
		voltage_mV = 0;
	}

    HAL_StatusTypeDef status;
    uint16_t convertedDataVoltage = (uint16_t)(((uint32_t)voltage_mV * 65535) / 5000); // 0-5000mV omzetten naar 16 bits waarde die naar de dac gestuurd kan worden. gebruik gehele getallen
    uint8_t txData[3];

    // Stel het adres en de data in voor het trigger-register van de DAC80501
    txData[0] = ADDR_DAC_DATA_register;                     // Registeradres
    txData[1] = (convertedDataVoltage >> 8 ) & 0xFF;      // MSB van de 16-bits data
    txData[2] = (convertedDataVoltage & 0xFF);              // LSB van de 16-bits data

    // Zet de Chip Select (CS/SS) lijn laag om SPI-communicatie te starten
    HAL_GPIO_WritePin(DAC_SS_Port, DAC_SS_Pin, GPIO_PIN_RESET);

    // Verzend de 24-bits data via SPI
    status = HAL_SPI_Transmit(&hspi1, txData, 3, DAC80501_SPI_TIMEOUT);

    // Zet de Chip Select (CS/SS) lijn hoog om SPI-communicatie te beëindigen
    HAL_GPIO_WritePin(DAC_SS_Port, DAC_SS_Pin, GPIO_PIN_SET);

    // Retourneer de status van de SPI-communicatie (HAL_OK of foutcode)
    return status;
}

HAL_StatusTypeDef DAC80501DataVoltage60V(uint16_t voltage_mV)  //data(getal) moet in mV zijn van 0 tot 5000mV
{
	//Zorgen dat spanning tussen 0-5000mV zit
	if(voltage_mV > 60000){ //Houdt de spanning onder de 5000mV
		voltage_mV = 60000;
	}
	if(voltage_mV < 0){ //Houdt de spanning boven de 0mV. Werkt niet goed vanwerge unsigned naar signed conversion bij functie aanroep
		voltage_mV = 0;
	}

    HAL_StatusTypeDef status;
    uint16_t convertedDataVoltage = (uint16_t)(((uint32_t)voltage_mV * 65535) / (5000*12)); // 0-60000mV omzetten naar 16 bits waarde die naar de dac gestuurd kan worden. gebruik gehele getallen
    uint8_t txData[3];

    // Stel het adres en de data in voor het trigger-register van de DAC80501
    txData[0] = ADDR_DAC_DATA_register;                     // Registeradres
    txData[1] = (convertedDataVoltage >> 8 ) & 0xFF;      // MSB van de 16-bits data
    txData[2] = (convertedDataVoltage & 0xFF);              // LSB van de 16-bits data

    // Zet de Chip Select (CS/SS) lijn laag om SPI-communicatie te starten
    HAL_GPIO_WritePin(DAC_SS_Port, DAC_SS_Pin, GPIO_PIN_RESET);

    // Verzend de 24-bits data via SPI
    status = HAL_SPI_Transmit(&hspi1, txData, 3, DAC80501_SPI_TIMEOUT);

    // Zet de Chip Select (CS/SS) lijn hoog om SPI-communicatie te beëindigen
    HAL_GPIO_WritePin(DAC_SS_Port, DAC_SS_Pin, GPIO_PIN_SET);

    // Retourneer de status van de SPI-communicatie (HAL_OK of foutcode)
    return status;
}
/* USER CODE END PFP */

/**
  * @brief  The application entry point.
  * @retval int
  */
int main(void)
{

  /* MCU Configuration--------------------------------------------------------*/

  /* Reset of all peripherals, Initializes the Flash interface and the Systick. */
  HAL_Init();

  /* Configure the system clock */
  SystemClock_Config();

  /* Initialize all configured peripherals */
  MX_GPIO_Init();
  MX_USART2_UART_Init();
  MX_SPI1_Init();
  /* Infinite loop */
  /* USER CODE BEGIN WHILE */

//  DAC80501Reset();
//  DAC80501Config();
//  DAC80501Gain();

//DAC80501DataVoltage5V(4999); //getal moet in mV zijn 0-5000mV
//  DAC80501DataVoltage60V();

  while (1)
  {
	  DAC80501DataVoltage5V(4999); //getal moet in mV zijn 0-5000mV
    /* USER CODE END WHILE */

    /* USER CODE BEGIN 3 */
  }
  /* USER CODE END 3 */
}

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
