justin040304/Stage-TEST-OK/Software recovered/DAC ADDON Kalibreren/DAC ADDON Kalibreren.ioc

Mcu.UserName=STM32L476RGTx
PA2.GPIO_Label=USART_TX
PA2.Signal=USART2_TX
PA3.GPIO_Label=USART_RX
PA3.Signal=USART2_RX
PA5.Signal=SPI1_SCK
PA7.Signal=SPI1_MOSI
PB10.Signal=SPI2_SCK
PB5.GPIO_Label=SS DAC
PB5.Signal=GPIO_Output
PB6.GPIO_Label=SS relais
PB6.Signal=GPIO_Output
PC13.GPIO_Label=B1 [Blue PushButton]
PC13.Signal=GPXTI13
PC3.Signal=SPI2_MOSI
