justin040304/Stage-TEST-OK/(notices)

Notices in the files:
Altium/DAC ADDON/ST Software/TEST qwith onboard led 2/Core/Inc/main.h:
Copyright (c) 2024 STMicroelectronics.
All rights reserved.
This software is licensed under terms that can be found in the LICENSE file
parts and their libraries:
SparkFun-Retired: Licensing:Creative Commons ShareAlike 4.0 International - https://creativecommons.org/licenses/by-sa/4.0
Wurth-Spacer-Studs-: Copyright: Würth Elektronik
